codecrafters-io/frontend/public/assets/images/referral-program-features/get-one-year-free.png

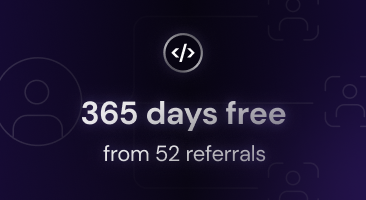
public/assets/images/referral-program-features/get-one-year-free.png
