codecrafters-io/frontend/public/assets/images/monthly-challenges/petoirobotdog.png

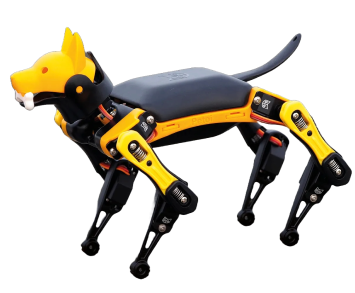
public/assets/images/monthly-challenges/petoirobotdog.png
