codecrafters-io/frontend/public/assets/images/affiliate-program-features/cc-profile-image.png

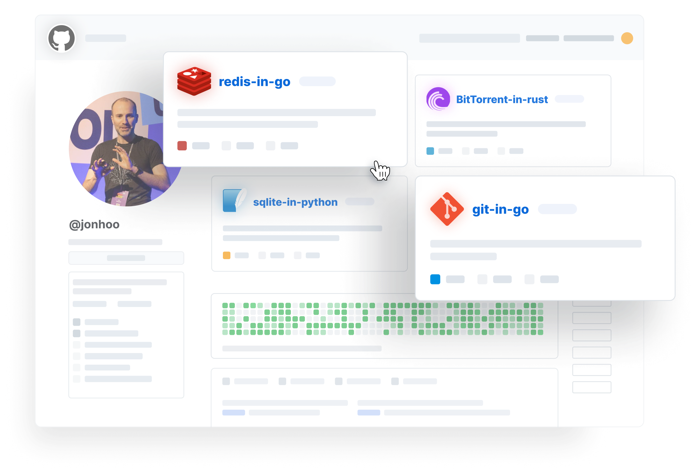
public/assets/images/affiliate-program-features/cc-profile-image.png
