codecrafters-io/frontend/public/assets/images/affiliate-program-features/free-for-friend.jpg

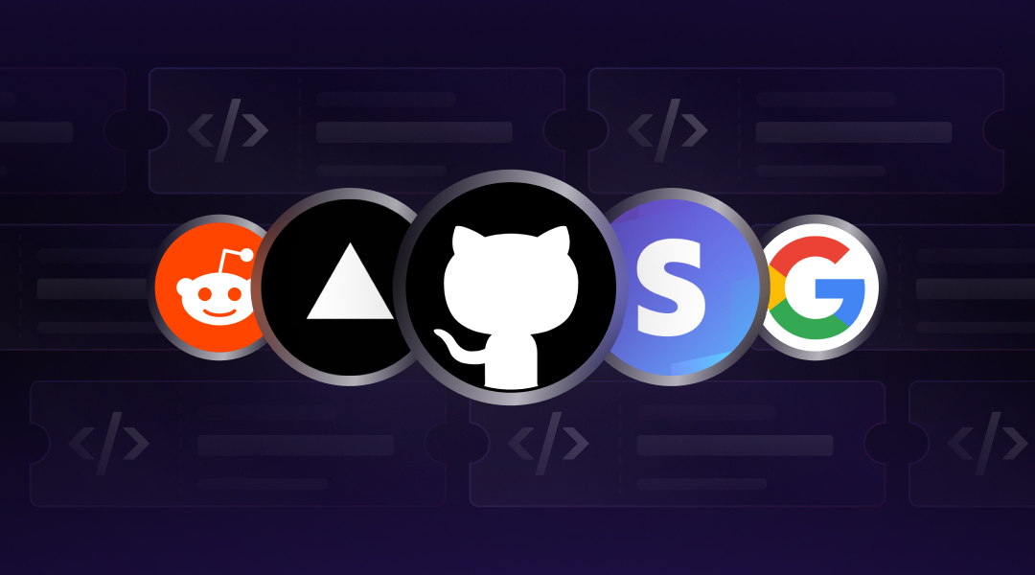
public/assets/images/affiliate-program-features/free-for-friend.jpg
