codecrafters-io/frontend/public/assets/images/affiliate-program-features/lifetime-earnings.jpg

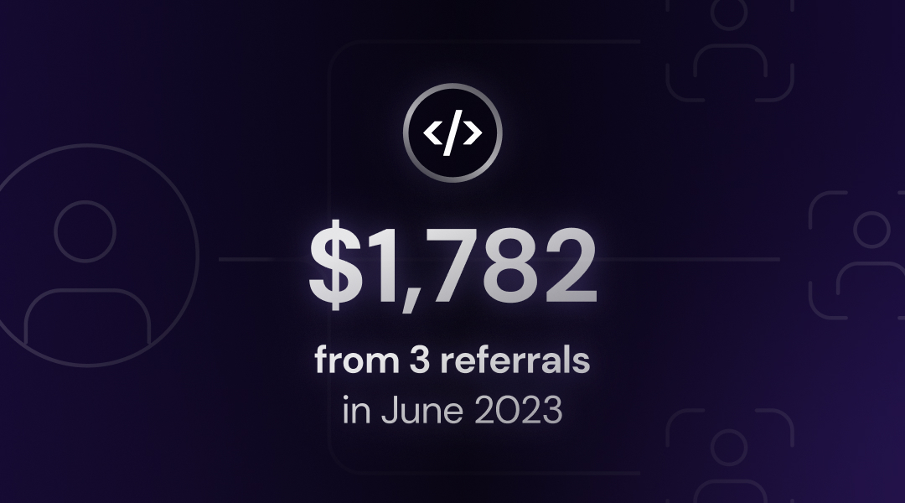
public/assets/images/affiliate-program-features/lifetime-earnings.jpg
