codecrafters-io/frontend/public/assets/images/affiliate-program-features/simple-payout.jpg

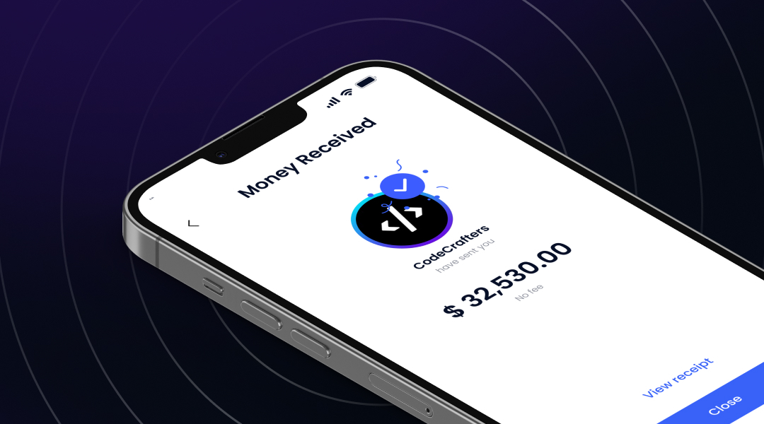
public/assets/images/affiliate-program-features/simple-payout.jpg
