codecrafters-io/frontend/public/assets/images/backer-headshots/arash-ferdowsi.png

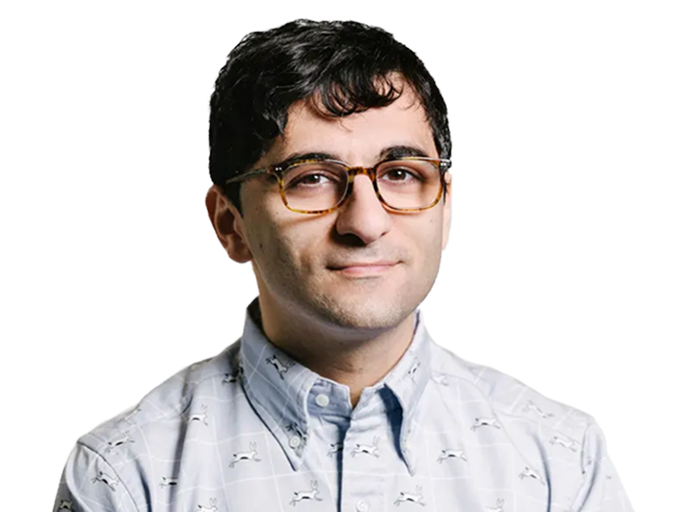
public/assets/images/backer-headshots/arash-ferdowsi.png
