codecrafters-io/frontend/public/assets/images/backer-headshots/jitendra-vaidya.png

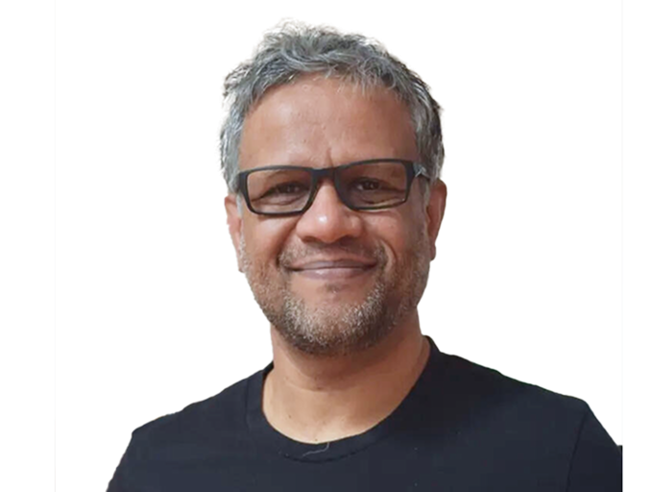
public/assets/images/backer-headshots/jitendra-vaidya.png
