codecrafters-io/frontend/public/assets/images/backer-headshots/jj-kasper.png

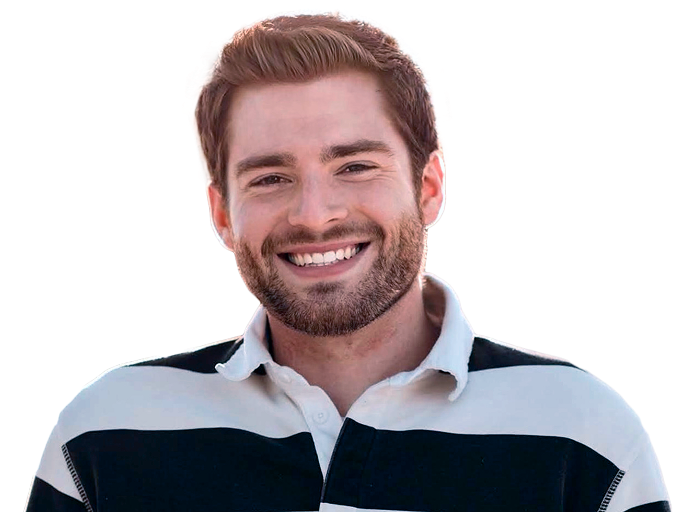
public/assets/images/backer-headshots/jj-kasper.png
