codecrafters-io/frontend/public/assets/images/backer-headshots/mike-krieger.png

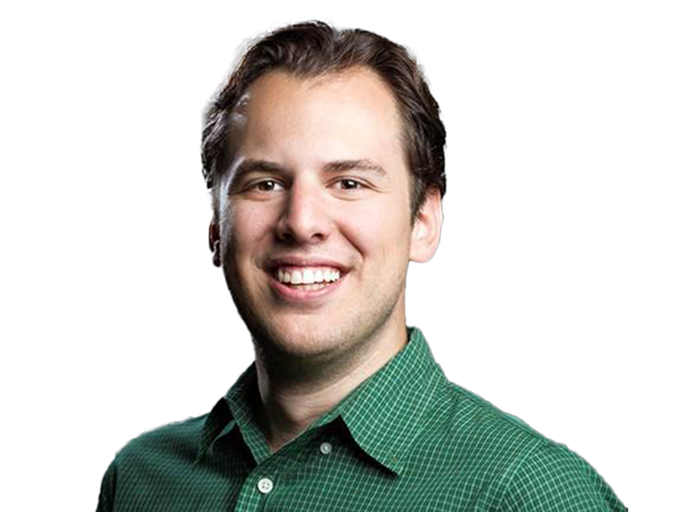
public/assets/images/backer-headshots/mike-krieger.png
