codecrafters-io/frontend/public/assets/images/backer-headshots/paul-copplestone.png

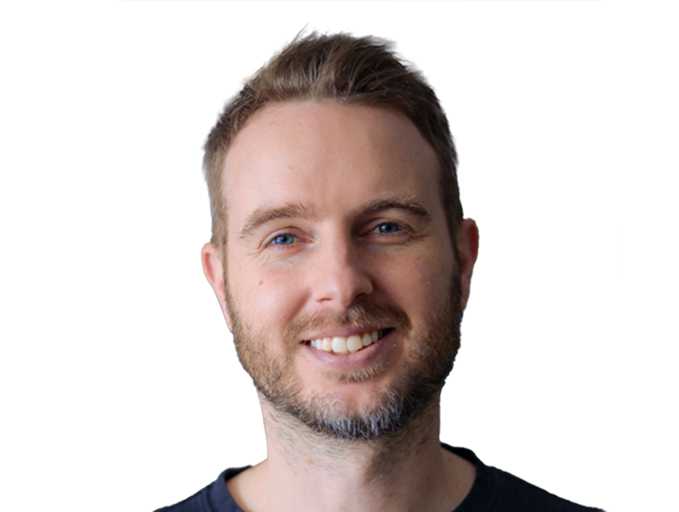
public/assets/images/backer-headshots/paul-copplestone.png
