codecrafters-io/frontend/public/assets/images/contest-og-images/og-amazon-contest-2.png

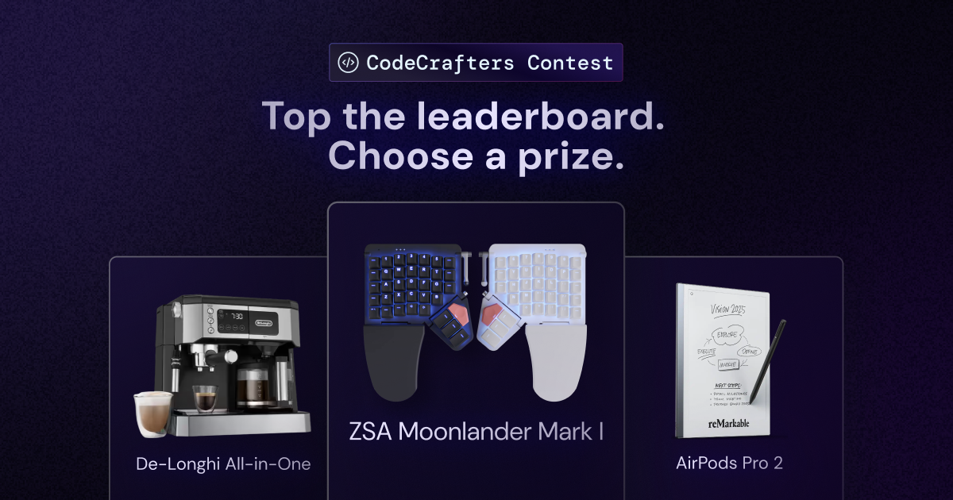
public/assets/images/contest-og-images/og-amazon-contest-2.png
