codecrafters-io/frontend/public/assets/images/contest-og-images/og-cais-contest-1.png

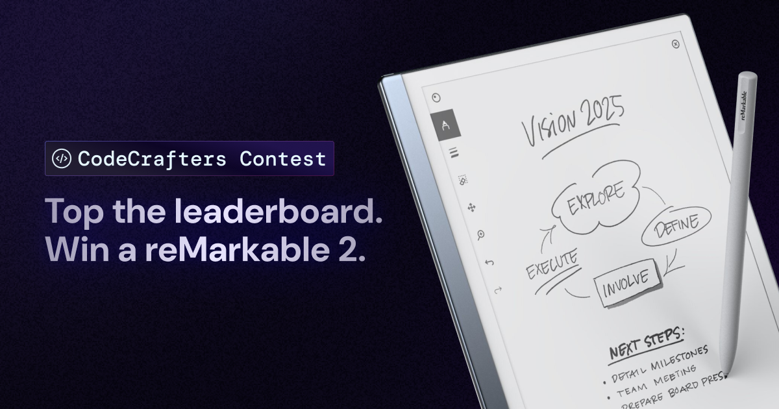
public/assets/images/contest-og-images/og-cais-contest-1.png
