codecrafters-io/frontend/public/assets/images/contest-prize-gif/amazon-contest-2-360.gif

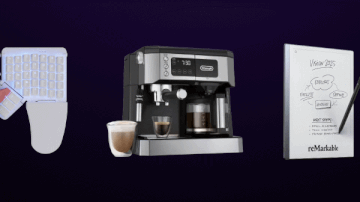
public/assets/images/contest-prize-gif/amazon-contest-2-360.gif
