codecrafters-io/frontend/public/assets/images/contest-prize-gif/cais-contest-1-600.png

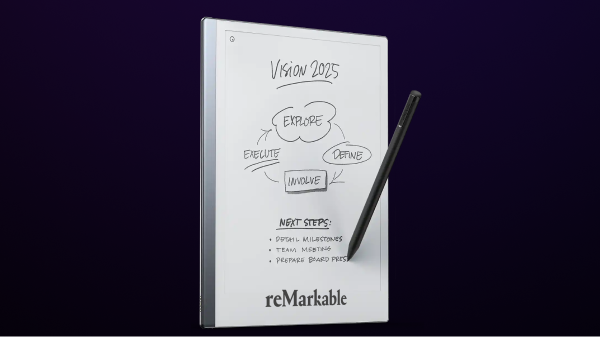
public/assets/images/contest-prize-gif/cais-contest-1-600.png
