codecrafters-io/frontend/public/assets/images/monthly-challenges/large.png

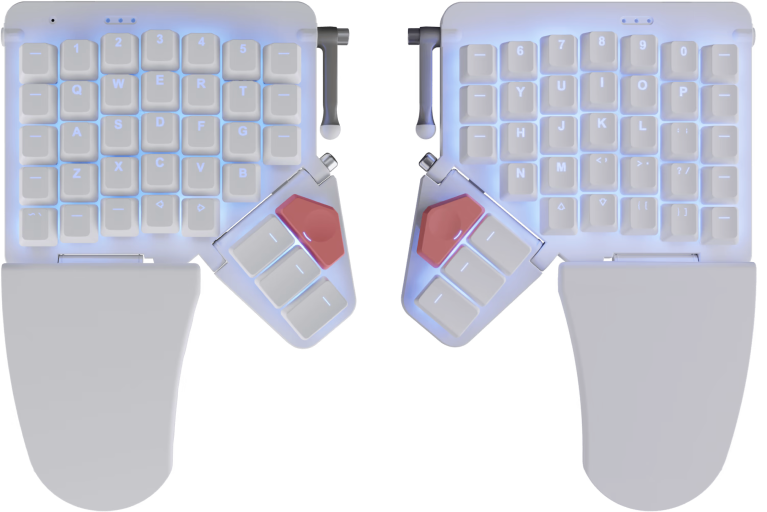
public/assets/images/monthly-challenges/large.png
