codecrafters-io/frontend/public/assets/images/monthly-challenges/opal-c1.png

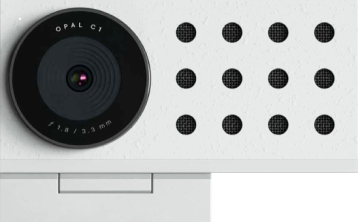
public/assets/images/monthly-challenges/opal-c1.png
