codecrafters-io/frontend/public/assets/images/monthly-challenges/oura-ring-horizon.png

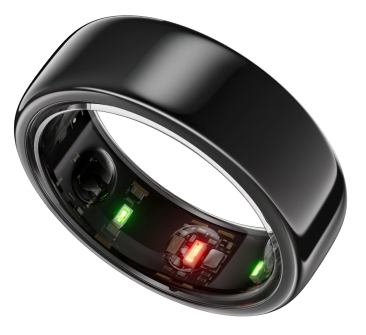
public/assets/images/monthly-challenges/oura-ring-horizon.png
