codecrafters-io/frontend/public/assets/images/monthly-challenges/small.png

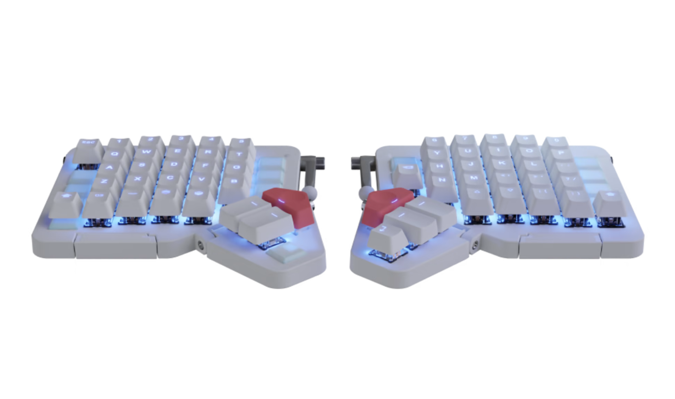
public/assets/images/monthly-challenges/small.png
