codecrafters-io/frontend/public/assets/images/referral-program-features/generate-link.png

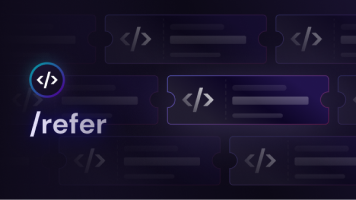
public/assets/images/referral-program-features/generate-link.png
