codecrafters-io/frontend/public/assets/images/Screenshot 2024-02-16 at 21.26.47.png

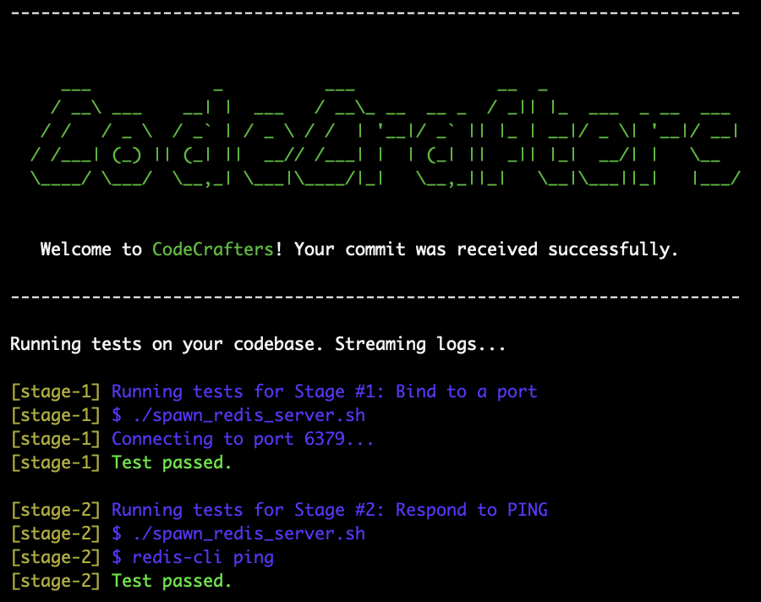
public/assets/images/Screenshot 2024-02-16 at 21.26.47.png
