codecrafters-io/frontend/public/assets/images/team-features/private-leaderboard.png

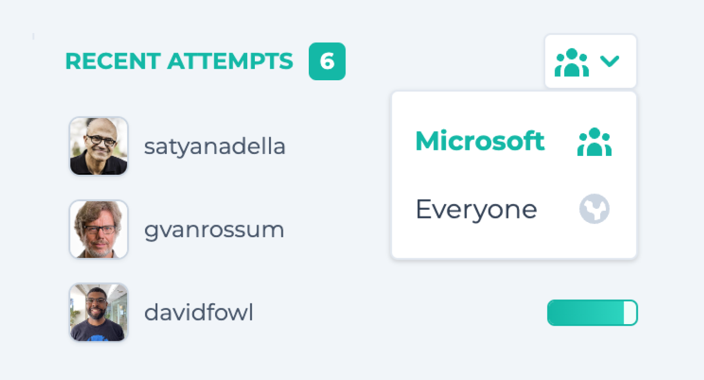
public/assets/images/team-features/private-leaderboard.png
