codecrafters-io/frontend/public/assets/images/team-features/slack-integration.png

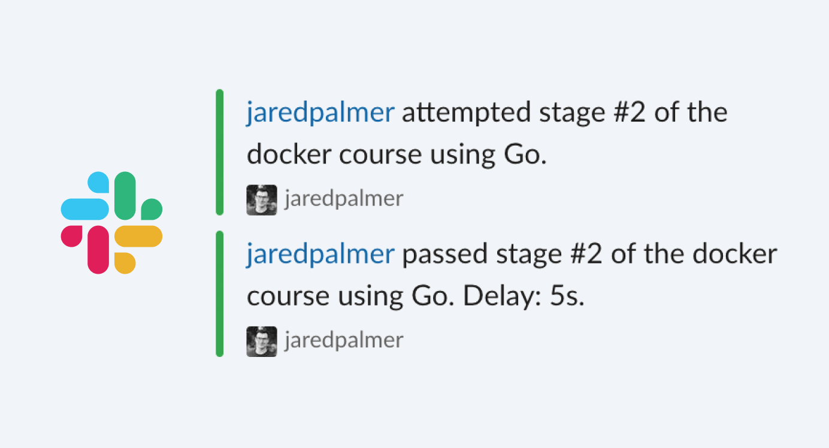
public/assets/images/team-features/slack-integration.png
