codecrafters-io/frontend/public/assets/images/team-features/team-billing.png

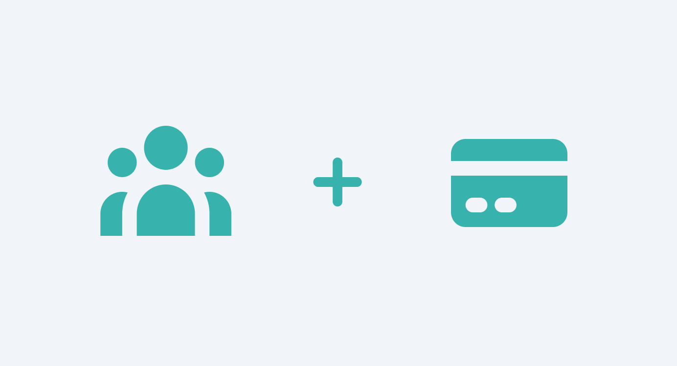
public/assets/images/team-features/team-billing.png
