codecrafters-io/frontend/public/assets/images/test.png

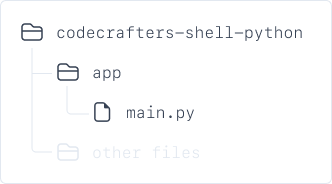
public/assets/images/test.png
