codecrafters-io/frontend/.rules/no-bugs.md

---
include: ['**/**.js', '**/**.ts', '**/**.hbs', '**/**.gts', '**/**.gjs']
---

Make sure our code follows these best practices, UNLESS there's a comment explaining why it's okay to break the rule.

1. Avoid typos.
2. Don't have like, really obvious bugs.
3. Follow reasonable conventions of the language we're programming in. No need to be too strict.
