codecrafters-io/frontend/(threads)

Thread 1415 (2024-03-05):

Dark Mode - foundations

rohitpaulk, 2024-03-05:
We've got a couple of pages / areas within pages that are currently in dark mode.

Examples:

- https://app.codecrafters.io/badges
- https://app.codecrafters.io/contests/weekly-7

We want to add dark mode throughout the app, but will do so incrementally since there'll be multiple components that need to be edited to make things look good.

As part of this task, let's add the "foundation" for this.

- We need dark mode state to be stored in local storage. The options are "light", "dark" and "system". The default will be "light".
- For staff, we need a way to toggle this in the UI. Let's add another link to account dropdown [here](https://github.com/codecrafters-io/frontend/blob/fd9d5570c1082fd6b1a0825d3b290c2e826b5487/app/components/header/account-dropdown.hbs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), below the Test Sentry link.
- When this is toggled, we need the "dark" class to be applied / removed from the application layout.
- Cleanup the `is-dark-mode` modifier - currently it's pretty hacky, uses intersectionobserver and what not
- Cleanup the `colorScheme` service, it currently uses hardcoded rules based on routes

Feel free to change the whole structure as much as you like, no need to stick to what we have already - most of this was added in a hurry and not properly thought out.

Note: We need all of this to work in such a way that customers aren't affected, but staff can toggle this at any time and inspect how things look. At the same time, once a staff switches things back to "light" mode, this should be treated the same as a regular user's browser. It's okay for `badges`, `contests` etc. to always be in dark mode, we aren't going to support light mode for those endpoints anytime soon.

Thread 1474 (2024-03-20):

"Update available" flow

rohitpaulk, 2024-03-20:
🚧 WIP

### Problem

We occasionally need to ship backend changes that are incompatible with new frontend versions.

### How we handle this currently

Until now our approach has been to keep changes backward compatible for a week or so, and then remove the backward compatibility code after.

### Requirements

We'd like to have a way to notify users that an update is available. We don't want to do this on _every_ update, only on ones that where we manually make a version bump.

rohitpaulk, 2024-07-29:
This was shipped!

Closed 2024-07-29.

Thread 1591 (2024-04-12):

Styling issue: Comments with code blocks extend past container

rohitpaulk, 2024-04-12:
From https://app.codecrafters.io/courses/http-server/stages/1:

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

(These comments might not be visible, so you'll need to create your own to actually replicate the issue)

rohitpaulk, 2025-01-31:
@VasylMarchuk can you confirm whether this has been fixed? I remember a seeing a PR that addressed something similar.

VasylMarchuk, 2025-03-30:
Nope, not yet fixed, tried looking at it today but didn't find an obvious fix

VasylMarchuk, 2025-04-05:
This has something to do with how avatars are displayed in the comments: if I hide them all, the sizing works flawlessly

Closed 2025-04-19.

Thread 2004 (2024-07-23):

Dark mode support tracking

rohitpaulk, 2024-07-23:
List of routes to add dark mode support for:

**Required for launch**:

- [x] catalog
- [x] account dropdown
- [x] course
- [x] course-overview
- [x] track
- [ ] vote
- [ ] concepts
- [ ] concept
- [ ] concept-group

**Not that important**:

- [ ] account-deleted
- [ ] code-walkthrough
- [ ] join
- [ ] login
- [ ] logged-in
- [ ] membership
- [ ] pay
- [ ] refer
- [ ] referral-link
- [ ] team
- [ ] teams.create
- [ ] update-required
- [ ] user
- [ ] not-found

rohitpaulk, 2025-01-31:
We've fixed most of there, the rest can be handled over time

Closed 2025-01-31.

Thread 2032 (2024-07-29):

Upgrade to ember 5.8

rohitpaulk, 2024-07-29:

VasylMarchuk, 2024-08-01:
Release notes:

- https://blog.emberjs.com/ember-released-5-8
- https://blog.emberjs.com/ember-released-5-7
- https://blog.emberjs.com/ember-released-5-6

VasylMarchuk, 2024-08-01:
Why not all the way to ember 5.10, which is currently latest? @rohitpaulk

rohitpaulk, 2024-08-01:
@VasylMarchuk LTS releases usually have fewer compatibility issues, 5.8 is the latest LTS if I'm not wrong. The only time we moved off LTS in the past was because there was an embroider compatibility issue and we had to upgrade to be able to use embroider.

VasylMarchuk, 2024-08-01:
Ah gotcha, 5.8 is latest LTS yep

Closed 2024-08-08.

Thread 2113 (2024-08-19):

Prevent spoiler alerts in Hints / CommentList

andy1li, 2024-08-19:
Re: [Help Scout #4875](https://secure.helpscout.net/conversation/2682855574/4875?viewId=4697252)

How can we prevent spoiler alerts?

Just listing ideas here, as a first step:

- Support collapse/uncollapse for the section. [Suggested by a user]
- Blur the section by default, like what we're doing with code examples for uncompleted stages.
- Some other way?

andy1li, 2024-08-20:
Moved to Linear.

Closed 2024-08-20.

Thread 2423 (2024-11-23):

Fix code block overflow in instructions card

rohitpaulk, 2024-11-23:
https://app.codecrafters.io/courses/bittorrent/stages/hw0

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

VasylMarchuk, 2024-11-24:
So if I change the way this magnet link is defined in the original instructions markdown from using single-ticks:

```
`magnet:?....`
```

to using triple-ticks, like this:

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

then it works @rohitpaulk:

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

VasylMarchuk, 2024-11-24:
I assume there's a way to edit the instructions markdown — but I'm not sure where?

rohitpaulk, 2024-11-25:
Ah, gotcha - @andy1li can you make that change please? @VasylMarchuk the markdown is stored [here](https://github.com/codecrafters-io/build-your-own-bittorrent/blob/main/course-definition.yml), but needs an admin to go and "apply" an update in the app.

@VasylMarchuk can you see if there's a CSS fix to prevent this happening even for inline code blocks? I can imagine cases where there's a not-so-long inline code block causing the same issue on smaller screens.

rohitpaulk, 2024-11-25:
Probably worth looking at what GitHub does: `thisisaverylongcodeblockthatisinlinethisisaverylongcodeblockthatisinlinethisisaverylongcodeblockthatisinlinethisisaverylongcodeblockthatisinlinethisisaverylongcodeblockthatisinlinethisisaverylongcodeblockthatisinlinethisisaverylongcodeblockthatisinlinethisisaverylongcodeblockthatisinline`

andy1li, 2024-11-25:
Testing too: ABC  `thisisaverylongcodeblockthatisinlinethisisaverylongcodeblockthatisinlinethisisaverylongcodeblockthatisinlinethisisaverylongcodeblockthatisinlinethisisaverylongcodeblockthatisinlinethisisaverylongcodeblockthatisinlinethisisaverylongcodeblockthatisinlinethisisaverylongcodeblockthatisinline` XYZ

VasylMarchuk, 2024-12-01:
> Probably worth looking at what GitHub does:

Ah, looks like they're simply using `word-wrap: break-word;` — cool, going to try this for our styles

Closed 2025-04-07.

Thread 2425 (2024-11-24):

Fix off-centered emoji in selected state

andy1li, 2024-11-24:
### Description
The emoji in the feedback modal appears off-centered when selected.

### Demo

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

https://demo.tryfix.ai/codecrafters/runs/c0b592b6-e4e5-41b7-bd2e-ee0438a74ba2?item=36

andy1li, 2025-01-05:
It seems to be fixed:

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

Closed 2025-01-05.

Thread 2515 (2025-01-05):

Markdowns are too wide in Bot comments to Code Examples

andy1li, 2025-01-05:
### Issue:

Users are forced to scroll horizontally to see the content of markdown.

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

### Reproduction Steps:

1. https://app.codecrafters.io/courses/http-server/stages/ia4/code-examples

2. language: go

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

3. user: bwfront

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

rohitpaulk, 2025-01-06:
This is a backend issue, the markdown content shouldn't contain a `pre` (the bot must be generating content with triple backticks inside)

rohitpaulk, 2025-01-13:
Just noting another user to test with: `jolly-pumpkin`.

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

rohitpaulk, 2025-01-13:
This is fixed for newer comments, running a job to fix older comments...

rohitpaulk, 2025-01-13:
Should be fixed now!

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

rohitpaulk, 2025-01-13:
@andy1li can we notify the user who let us know of this please?

Closed 2025-01-13.

Thread 2607 (2025-01-31):

Statically rendered user pages + concept pages

rohitpaulk, 2025-01-31:
We've been pre-rendering track pages and challenge pages by enumerating over all available tracks and challenges. We now need to find a way to statically generate user pages (there are 1000s of these), and concept pages (we'll have 100s of these in the near future).

Vercel's [Prerender functions](https://vercel.com/docs/build-output-api/v3/primitives#prerender-functions) API is supposed to allow for generating these on demand and caching. Let's implement this and also see if we can expose this as a generic ember plugin that others can use.

rohitpaulk, 2025-01-31:
@VasylMarchuk can you look into this please?

rohitpaulk, 2025-01-31:
@VasylMarchuk this is a bit time-sensitive, let's try to have it out by Feb 10

rohitpaulk, 2025-01-31:
For additional context - the reason we can't use the existing pre-rendering setup for these is that there are 1000s of these pages, and our deploys would take hours if we were to pre-render all of these pages.

VasylMarchuk, 2025-02-01:
Looking into this. Also, is my suspicion correct that since we're now going to render user-generated content (their user pages), we need to fix the DOMPurify `sanitize` issue? @rohitpaulk

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

rohitpaulk, 2025-02-04:
@VasylMarchuk yeah, we'll need to do something about that since user pages can contain UGC. It's okay if we do this in a hacky manner for now though - for example, if we just HTML-escaped all content when in fastboot mode (so it doesn't insert things like <script> tags), that might work. We can then re-visit getting DOMPurify to work properly in a different issue.

rohitpaulk, 2025-02-22:
This is done now! All's that pending is to make the 404 for concept pages work.

Closed 2025-03-29.

Thread 2782 (2025-04-06):

Errors that happen when executing Prerender Functions are not caught

VasylMarchuk, 2025-04-06:
### Brief

After closing #2607, it is possible for errors to sneak in that happen only when our Prerender Functions are executed, and nothing currently is checking for them or triggering any alerts/notifications.

### Details

As a simple solution, we have to pre-render one User and one Concept page **at deployment time using Prember**, to catch any potential errors during deployment.

Closed 2025-04-07.

Thread 2860 (2025-05-28):

Sync hover state for collapsed lines gutter and editor

rohitpaulk, 2025-05-28:
Let's have this feel like a single element by syncing hover state:

https://github.com/user-attachments/assets/18305773-b0d3-4c72-b410-40e3e840213b

This should be done for both the diff view and the file view. If it makes it easier, we can discard the codemirror unchanged lines collapse implementation and just replace that whole usage with ours since we now have a custom collapsed lines implementation.

Closed 2025-06-11.

Thread 3100 (2025-09-16):

SIdebar expansion icon should not be hidden by content mask

rohitpaulk, 2025-09-16:
In the course page, when content is hidden by a modal the sidebar expansion icon is half-hidden:

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

This should instead appear above the content mask
