codecrafters-io/frontend/(commit log)

2024-05-06 fix: Add an isDisabled clause to the move down button
2024-05-06 feat: Added assertions in test for disabled buttons on first and last options
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2024-05-12 feat: Handle case where an option index that is out of bounds is passed to handler
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2024-05-13 Refactor non-active repository link template
    The non-active repository link template in the course page repository dropdown has been refactored. Changes include:
    • Added proper indentation and line breaks for better readability.
    • Reorganized the image tags for the repository language logos.
    • Added a missing newline at the end of the file.
    These changes improve the structure and maintainability of the template.
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2024-05-14 Add onExpand event handler to CommunitySolutionCardComponent and CommunitySolutionsListComponent. When the onExpand event is triggered, it checks if the user is authenticated and then calls the creat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
2024-05-14 Refactor community solution card components and add metadata for upvote and downvote buttons.
2024-05-16 Refactor code example evaluator page components and routes
    The commit message summarizes the changes made to the code. In this case, the changes involve refactoring the code example evaluator page
    components and routes.
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2024-05-20 Refactor code to remove unnecessary arguments in ActionButtonListComponent and fix pin-code-example test
2024-05-20 Fix stage URLs in acceptance tests and update progress text in leaderboard test.
2024-05-20 Update course and track progress display
    The commit message summarizes the changes made in the code. In this case, the changes involve updating the progress display for courses and
    tracks in the acceptance tests. The progress text and progress bar style have been modified to reflect the correct number of stages.
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2024-05-22 Update branch name from 'master' to 'main' in GitHub workflows and README.md
    This commit updates the branch name from 'master' to 'main' in the following files:
    • .github/workflows/test.yml
    • README.md
    • sweep.yaml
    The changes include updating the branch name in the on section of the workflow file, the condition for enabling Percy in the
    workflow file, and the deployment description in the README.md file.
    This commit also updates the branch name in the sweep.yaml file, specifically in the branch field.
    These changes ensure consistency with the updated branch naming convention.
2024-05-22 fix stage comments test
2024-05-23 refactor: Avoid conditionally setting up timer in initializer
2024-05-23 Fix race condition causing blank explanation in FeedbackPromptComponent and save the explanation in submit-course-stage-feedback-test.js.
2024-05-26 Update import path for syncRepositoryStageLists in repositories.js
    This commit updates the import path for syncRepositoryStageLists in repositories.js from './utils/sync-repository-stage-lists'
    to '../utils/sync-repository-stage-lists'. This change ensures that the correct module is imported and used in the code.
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2024-05-27 feat: Add test for submitting course stage feedback after passing base stage
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2024-05-29 refactor: Add method that advances time in time service instead of relying on fake-timers
2024-05-29 fix: Handle case where isFastboot is true
2024-05-29 Add copy to clipboard functionality and handle button click in evaluation-tab component.
2024-05-29 Update evaluation sorting and display in code example evaluator page and evaluation card components.
    • Sort evaluations by updatedAt instead of createdAt in EvaluationsSection component.
    • Display "Regenerating..." text when evaluation requires regeneration in evaluation-tab.hbs template.
    • Display updatedAt instead of createdAt in header.hbs template.
    • Add updatedAt attribute to CommunitySolutionEvaluationModel model.
    These changes improve the accuracy of evaluation sorting and provide updated information in the UI.
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2024-06-05 feat: Added another test to check if modal status is affected by updates to course stage
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2024-06-10 feat: Filtered out deprecated course stages from being included in stages count in language cards on tracks page
2024-06-10 feat: Filtered out course progress list items for deprecated courses on the user profile page
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2024-06-21 feat: Added tooltip for refresh from github button when anonymous mode is enabled
2024-06-21 fix: Ensure tooltip is not affected by stylistic changes of button being disabled
2024-07-02 build(deps-dev): Bump @types/rails__actioncable from 6.1.10 to 6.1.11
    Bumps [@types/rails__actioncable](https://github.com/DefinitelyTyped/DefinitelyTyped/tree/HEAD/types/rails__actioncable) from 6.1.10 to 6.1.11.
    - [Release notes](https://github.com/DefinitelyTyped/DefinitelyTyped/releases)
    - [Commits](https://github.com/DefinitelyTyped/DefinitelyTyped/commits/HEAD/types/rails__actioncable)
    ---
    updated-dependencies:
    - dependency-name: "@types/rails__actioncable"
    dependency-type: direct:development
    update-type: version-update:semver-patch
    ...
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2024-07-16 Use a map instead of using a switch (to make CodeRabbit happier)
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2024-07-27 Refactor continue-or-step-back.ts: Update button text and visibility
    The commit message summarizes the changes made to the file "continue-or-step-back.ts". In this commit, the button text and visibility properties were
    modified. The continue button text was updated, and the step back button visibility property was removed. The changes were made to improve the user
    experience and enhance the functionality of the component.
2024-07-28 Remove unused button-with-spinner.js file and add button-with-spinner.ts file with glimmer component implementation.
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2024-08-11 Add course stage slugs to participation query and display system submission in timeline entry container.
2024-08-12 build(deps): Bump @rails/actioncable from 7.1.3 to 7.2.0
    Bumps [@rails/actioncable](https://github.com/rails/rails) from 7.1.3 to 7.2.0.
    - [Release notes](https://github.com/rails/rails/releases)
    - [Commits](https://github.com/rails/rails/compare/v7.1.3...v7.2.0)
    - dependency-name: "@rails/actioncable"
    dependency-type: direct:production
    update-type: version-update:semver-minor
    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
2024-08-19 chore(deps-dev): bump ember-svg-jar from 2.4.9 to 2.5.0
    Bumps [ember-svg-jar](https://github.com/voltidev/ember-svg-jar) from 2.4.9 to 2.5.0.
    - [Release notes](https://github.com/voltidev/ember-svg-jar/releases)
    - [Changelog](https://github.com/evoactivity/ember-svg-jar/blob/master/CHANGELOG.md)
    - [Commits](https://github.com/voltidev/ember-svg-jar/commits)
    - dependency-name: ember-svg-jar
    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
2024-08-21 Fix auto-selecting of Preferred Language by queryParams['track']
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2024-08-23 Refactor components to improve TypeScript compatibility and update dependencies.
    [course-idea-card.gts, submit-course-idea-card.gts, unvote-button.gts, vote-button.gts]
2024-08-23 update invert styling
    [vote-button.gts]
2024-08-23 chore(deps): bump @rails/actioncable from 7.2.0 to 7.2.100
    Bumps [@rails/actioncable](https://github.com/rails/rails) from 7.2.0 to 7.2.100.
    - [Commits](https://github.com/rails/rails/commits)
    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
2024-10-02 chore(deps-dev): bump ember-svg-jar from 2.5.0 to 2.6.0
    Bumps [ember-svg-jar](https://github.com/voltidev/ember-svg-jar) from 2.5.0 to 2.6.0.
    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
2024-10-07 Add support for zero decimal currencies in Charge model and normalize amounts.
2024-10-07 Update currency formatting for CNY to include 'CN' prefix in charge model.
2024-10-07 Fix currency formatting for CNY in Charge model.
2024-10-07 fix: update currency symbol from C$ to CA$ for Canadian dollars in charge model
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2024-10-16 chore(deps): bump @rails/actioncable from 7.2.100 to 7.2.101
    Bumps [@rails/actioncable](https://github.com/rails/rails) from 7.2.100 to 7.2.101.
    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
2024-10-17 Update modal text to refer to "current step" instead of specific step title.
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2024-10-18 Update modal text to conditionally display "stage" or "step" based on type.
2024-10-24 chore(deps): bump @rails/actioncable from 7.2.101 to 7.2.102
    Bumps [@rails/actioncable](https://github.com/rails/rails) from 7.2.101 to 7.2.102.
    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
2024-10-31 chore(deps): bump @rails/actioncable from 7.2.102 to 7.2.200
    Bumps [@rails/actioncable](https://github.com/rails/rails) from 7.2.102 to 7.2.200.
    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
2024-11-05 Prevent submit when button is disabled
2024-11-13 Add loading state for delete button and prevent multiple deletions in modal.
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2024-11-16 Refactor feature flag checks for stage 2 solutions to improve logic clarity.
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2024-11-22 Rename second stage instructions card to second stage tutorial card across files.
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2024-11-22 Fix ID in second-stage tutorial card and remove unnecessary pause in tests.
2024-11-22 Update test cases to suggest Git commands for stage 2 and CLI for stage 3.
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2024-11-26 Refactor resume track button logic and add acceptance tests for track-page [percy]
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2024-11-29 Add hide solution button functionality and test coverage for second stage tutorial card.
2024-11-29 fix: Update button class in implement-solution-step.hbs [percy]
2024-12-03 chore(deps): bump @rails/actioncable from 7.2.200 to 8.0.0
    Bumps [@rails/actioncable](https://github.com/rails/rails) from 7.2.200 to 8.0.0.
    - [Commits](https://github.com/rails/rails/commits/v8.0.0)
    update-type: version-update:semver-major
    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
2024-12-11 chore(deps): bump @rails/actioncable from 8.0.0 to 8.0.1
    Bumps [@rails/actioncable](https://github.com/rails/rails) from 8.0.0 to 8.0.1.
    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
2024-12-13 feat: Add feature flag to show tweaks for stage 1 tutorial card in first-stage-tutorial-card component [percy]
2024-12-17 fix: Correct optional chaining in two components
2024-12-18 chore: Fix typo in error message in course-stage model
2024-12-19 fix: Update member listing to display GitHub name and modify test to click leave button by GitHub name instead of username. Fix memberByGithubName method to find member by GitHub name.
2024-12-21 refactor: Modify code to show short instructions for stage 2 based on feature flag status
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2024-12-23 fix: Update variable name in FirstStageTutorialCardComponent to currentCourse (#123)
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2024-12-26 Revert "Experiment: Stage 1 - Hide Test Runner Card Before User Has Submitted Again"
2024-12-27 feat: Add option to show all steps at once in first-stage tutorial card [percy]
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2024-12-27 chore: Remove unnecessary code duplication and improve forum link in first stage tutorial card and instructions page
2024-12-27 feat(stage): rename `shouldShowNeedHelpForumLink` to `shouldShowStage1ForumLinkCTA` and update its logic
    Updated the name of the `shouldShowNeedHelpForumLink` property to `shouldShowStage1ForumLinkCTA` and modified its logic to align with its new name.
2024-12-31 fix: Add repo query param to start-track-button component
    Updated the start-track-button component to include a 'repo' query param when transitioning to the course route if the user is not anonymous. This change allows for better handling of repository information in the transition.
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2025-01-06 refactor: Remove the feature flag for showing all steps at once for first stage tutorial card
2025-01-06 feat: Remove feature flag for showing short instructions in second stage tutorial card
2025-01-07 feat: Add conditional rendering for terminal instructions in first and second stage tutorial cards and feature flag logic [percy]
2025-01-07 refactor: Update tutorial cards layout and tooltips on course page stage steps
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2025-01-07 fix: Update conditional logic for showing terminal instructions in first-stage-tutorial-card component
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2025-01-12 fix: Update second stage tutorial message in course-stage-step component
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2025-01-18 feat: update discount models and refactor related logic
    Refactor the discount handling in the application by introducing a new
    PromotionalDiscount model. Update the included resources to use
    consistent naming conventions. Modify the logic in various components
    to utilize the new model and properties, ensuring that discount
    calculations reflect the current user's active discounts. This
    improves code clarity and enhances the user experience by providing
    accurate discount information.
2025-01-22 refactor: move UpgradePrompt component to new location
    Moves the UpgradePrompt component from the course-stage-step
    directory to the course-page directory. This change improves
    the organization of components by grouping related files
    together, enhancing maintainability and clarity in the codebase.
2025-01-22 refactor: comment out user sync during discount fetch
    Comments out the call to sync the current user in the
    handleDidInsert method. This change improves performance
    by preventing unnecessary user synchronization while
    fetching regional discounts.
2025-01-22 feat(auth): refactor user synchronization and login flow
    Removes deprecated login and logout methods from the
    AuthenticatorService. Introduces a new UserSyncer service
    to handle user synchronization on route changes, ensuring
    that user data is up-to-date. Updates the authenticate
    method to call syncCurrentUser, improving the login flow
    and user experience. Adjusts the AcceptReferralButton
    component to use syncCurrentUser for refreshing user
    data, enhancing consistency across the application.
2025-01-22 refactor: remove forceSync method and streamline sync logic
    Eliminate the redundant forceSync method to simplify the codebase.
    Update the handleRouteChange method to directly call syncCurrentUser,
    ensuring a more efficient synchronization process for the current user.
    This change enhances maintainability and improves clarity in the
    synchronization workflow.
2025-01-22 refactor: instance initializers to TypeScript
    Convert JavaScript instance initializers to TypeScript for better
    type safety and maintainability. Remove outdated JavaScript files
    and implement TypeScript versions for `sentry`, `current-user`,
    `page-view-tracker`, `web-vitals`, `posthog`, and `feature-flag-syncer`.
    This change enhances code quality and prepares the codebase for
    future development.
2025-01-22 fix: update isPaid condition for course stages
    Adjust the isPaid condition to include courses at position 3. This
    change ensures that the correct payment status is applied to
    courses that are at the third position or higher.
2025-01-22 fix: enable user synchronization on upgrade prompt
    Enables user synchronization in the upgrade prompt component
    by uncommenting the syncCurrentUser method. This ensures that
    the current user's data is properly synchronized when the
    component is inserted, improving the accuracy of user-related
    information displayed on the course page.
2025-01-22 feat: add second stage completion trait and tests
    Implement the `withSecondStageCompleted` trait to create
    submissions for the first two stages of a course with
    failure and completion statuses. Add acceptance tests to
    verify the upgrade prompt displays the correct copy based
    on user eligibility for discounts. This enhances the
    course progression simulation and ensures accurate
    user messaging.
2025-01-23 feat: enhance signup discount notice component [percy]
    Updates the signup discount notice with a new design and
    functionality. Changes include a gradient background, an
    animated icon, and a countdown timer for the offer's
    expiration. Adds a tooltip for additional information on
    the annual plan discount. This improves user engagement
    and clarity on the offer details.
2025-01-23 refactor: extract time formatting logic into a utility function
    This commit introduces a new utility function `formatTimeLeft` in `time-formatting.ts` to handle the countdown timer logic for discount expiration. The `timeLeftText` getters in both `ReferralDiscountNoticeComponent` and `SignupDiscountNoticeComponent` have been updated to utilize this new function, simplifying the code and improving maintainability.
2025-01-23 refactor: consolidate referral discount notice logic into a single component
    This commit removes the `referral-discount-notice-with-countdown.hbs` file and integrates its functionality into `referral-discount-notice.hbs`. The component now conditionally renders different layouts based on the `@variant` property, simplifying the code structure and improving maintainability. The countdown timer and referral offer details are preserved, enhancing the user experience.
2025-01-23 refactor: integrate countdown notice into signup discount component
    This commit removes the `signup-discount-notice-with-countdown.hbs` file and incorporates its functionality into `signup-discount-notice.hbs`. The component now conditionally renders different layouts based on the `@variant` property, maintaining the countdown timer and offer details while simplifying the code structure. This change enhances maintainability and improves the user experience.
2025-01-24 feat(billing): add discount timer badge component
    Implement the DiscountTimerBadge component to display a countdown for
    promotional discounts. Integrate the component into the header and
    navigation controls, replacing existing VIP and member badge logic.
    Add acceptance tests to verify the discount countdown functionality.
    This enhances user experience by providing timely information on
    discounts available.
2025-01-24 feat(header): integrate active discount display in header component
    - Added logic to conditionally render the DiscountTimerBadge based on the active discount for the yearly plan.
    - Introduced a computed property to retrieve the active discount from the current user, enhancing the user interface with real-time discount information.
2025-01-24 feat: enhance navigation controls to display active discount for yearly plan
    - Updated the navigation controls to conditionally render the DiscountTimerBadge with the active discount information for the yearly plan.
    - Introduced a computed property to retrieve the active discount from the current user, improving the user interface with real-time discount visibility.
2025-01-27 feat: add BillingStatusBadge component for dynamic billing status rendering
    Create a new component to handle various billing status scenarios, including VIP badge, member badge, discount timer, free weeks, and upgrade button
2025-01-27 feat: add `size` prop to `BillingStatusBadge` component
    Add a size prop to the BillingStatusBadge component to support different display sizes in header and course page navigation controls
2025-01-27 feat: add size prop to VIP badge component
    Enhance VipBadge component with configurable size options, supporting 'small' and 'large' display sizes with responsive styling
2025-01-27 feat: add size prop to Member badge component
    Enhance MemberBadge component with configurable size options, supporting 'small' and 'large' display sizes with responsive styling
2025-01-27 feat: propagate size prop to DiscountTimerBadge component
    Update DiscountTimerBadge to accept and apply the size prop consistently, adding margin for small size and maintaining responsive styling
2025-01-27 feat: add size prop to FreeWeeksLeftButton component
    Enhance FreeWeeksLeftButton with configurable size options, supporting 'small' and 'large' display sizes with responsive margin and button sizing
2025-01-27 refactor: update FreeWeeksLeftButton component size prop handling
    Modify the component to map size prop values more precisely, adjusting the linkButtonSize getter and template to ensure consistent sizing and margin behavior
2025-01-27 feat: enhance BillingStatusBadge upgrade button sizing and margin
    Modify the BillingStatusBadge component to dynamically adjust the upgrade button size and margin based on the size prop, ensuring consistent styling across different contexts
2025-01-27 refactor: update MemberBadge component size prop mapping
    Modify the MemberBadge component to map size prop values more precisely, adjusting the linkButtonSize getter and template to ensure consistent sizing and margin behavior
2025-01-29 fix: correct conditional rendering for discount timer badge
    Adjust the condition for displaying the discount timer badge to ensure it only shows when both an active yearly plan discount exists and the discount countdown can be seen
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2025-01-29 fix: add glint type assertion for discount timer badge
2025-01-29 feat: add stage 2 completion promotional discount type
    Extend promotional discount model and user model to support a new 'stage_2_completion' discount type, enabling additional discount scenarios
2025-01-29 feat: add Stage 2 completion discount notice component
    Create a new component to display a promotional discount notice for users who complete stage 2, featuring a time-limited 40% off annual plan offer with animated icon and tooltip
2025-01-29 feat: render Stage 2 completion discount notice on pay page
    Add conditional rendering for the new Stage 2 completion discount notice component when applicable, integrating the promotional discount display into the pay page template
2025-01-29 feat: add promotional discounts to repository poller and extend pay page tests
    Add 'user.promotional-discounts' to repository poller tracked events and expand pay page test coverage with new scenarios for Stage 2 completion discount and course stage completion
2025-01-29 test: add test for Stage 2 completion discount flow
    Extend pay page tests to verify the Stage 2 completion discount mechanism, including creating a test scenario that simulates completing stage 2 and checks the associated promotional discount
2025-01-29 test: enhance Stage 2 completion discount test coverage
    Update pay-test.js to improve test scenarios for Stage 2 completion discount, including:
    - Adding explicit assertions for discount timer badge visibility and time remaining
    - Verifying badge click navigates to pay page
    - Refining test case descriptions and implementation details
2025-01-29 test: add discount timer badge page object methods
    Enhance page object files for header components by:
    - Adding isVisible method for discount timer badge
    - Including text and timeLeftText methods
    - Standardizing discount timer badge page object structure across components
2025-01-29 test: adjust Stage 2 completion discount timer test assertions
    Update pay-test.js to fine-tune discount timer badge test assertions:
    - Modify expiration time calculation to reflect 23 hours remaining
    - Ensure accurate time remaining text matches expected behavior
2025-01-29 test: update view-discount-countdown test assertions
    Refactor discount timer badge test assertions to use page object methods:
    - Replace direct DOM assertions with page object methods
    - Improve test readability and maintainability
    - Standardize assertion approach across different test scenarios
2025-01-29 test: add size-related methods to discount timer badge page objects
    Add hasSmallSize and hasLargeSize methods to header component page objects for discount timer badge, enabling size-related assertions in tests
2025-01-29 test: extract billing status badge page object to shared component
    Refactor page objects for header and course page header by:
    - Creating a new shared billing-status-badge.js page object
    - Moving common badge and button selectors to the shared component
    - Simplifying import and usage across different page objects
2025-01-29 test: adjust Stage 2 completion discount timer test expiration time
    Update pay-test.js to modify the Stage 2 completion discount timer test:
    - Change expiration time calculation from 24 hours minus 10 seconds to 24 hours minus 30 minutes
    - Ensure more realistic test scenario for discount timer badge
2025-01-29 fix track preview [percy]
2025-01-30 feat: sync user after stage completion and remove promotional discounts fetching from repo poller
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2025-01-30 feat: enhance discount badge display logic for Stage 2 completion when using feature flags
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2025-02-01 feat: add support for additional attributes in leaderboard
    Update the track leaderboard component to accept additional
    attributes. This change enhances the component's flexibility
    by allowing it to be more easily integrated with other
    elements and styles in the application.
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2025-02-04 feat: add getter for active yearly plan discounts excluding stage 2 completion
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2025-02-04 refactor: update header spacing and layout adjustments
    Reduce the bottom margin of the track title for better spacing.
    Adjust the layout of the track page by modifying padding and
    margins for a more consistent design. Simplify the track
    description markdown method to improve readability and
    maintainability.
2025-02-04 feat(header): add statistics component to track page header
    Introduce a new `TrackPage::Header::Statistic` component to display
    statistics in the track page header. This component accepts `description`
    and `icon` as arguments, enhancing the visual representation of key
    metrics. Update the header template to include two instances of this
    component, showcasing the number of learners and exercises. Adjust
    styling for better layout and readability.
2025-02-04 feat: update track header to use dynamic language name
    Refactor the track page header to display the language name
    dynamically. Remove the `trackTitle` getter from the language
    model and directly integrate the name into the header. This
    improves localization and ensures the title reflects the
    current language context.
2025-02-04 feat(header): improve layout and responsiveness of header
    Adjusts the header layout by modifying the flex properties and
    margins for better spacing. Adds a responsive LanguageLogo
    component that displays on smaller screens, enhancing the
    user experience across devices.
2025-02-04 feat(header): update statistic description to use dynamic count
    Update the TrackPage header to display the number of exercises
    dynamically based on the current language's stages count. This
    change enhances the user experience by providing accurate and
    localized information.
2025-02-04 refactor: restructure track.hbs layout for clarity
    Wraps the main content in a white background for better
    visual separation. Adjusts indentation for improved
    readability and maintains the existing structure of
    components. This change enhances the overall layout
    and prepares for future modifications.
2025-02-04 implement dark mode [percy]
    Enables dark mode for the track page by updating styles and
    components. Changes include modifying button styles, adding
    dark mode snapshots in tests, and adjusting text colors for
    better visibility. This improves user experience for users
    who prefer dark mode.
2025-02-04 fix(header): increase max width of track description
    Update the max width of the track description paragraph to
    max-w-2xl for better readability. This change enhances the
    visual presentation of the track description on the page.
2025-02-04 feat: update page title for concept editing view
    Change the page title in the concepts admin template to reflect the
    specific concept being edited. The title now concatenates "Edit Concept: "
    with the concept's title or defaults to "Unknown" if no title is present.
    This improves clarity for users by providing context on the current
    action being performed.
2025-02-05 revert: changes made to track checkout button clicks
2025-02-11 feat(header): update layout for better
    Adjusts the layout by adding "flex-grow" class to the
    container div. This change improves the spacing and alignment
    of the header elements, enhancing the overall visual
    presentation of the track page.
2025-02-11 feat: add join-track route and model handling
    Implements the join-track route to manage track joining
    functionality. This includes defining the model structure,
    loading necessary data, and handling transitions based on
    affiliate links and language. The route allows anonymous
    access and updates metadata for SEO purposes.
2025-02-11 feat: enhance track page with join functionality
    Adds a new join track page that reuses components from the track
    page. Implements conditional rendering for call-to-action
    in the header based on user state. Updates page titles to reflect
    the user's affiliate link. Introduces tests for the new join track
    page to ensure functionality.
2025-02-11 feat: add language support to affiliate link components
    Adds language handling to the affiliate link page components.
    Introduces a new `language` argument in the `AcceptReferralContainer`
    and `AcceptReferralButton` components. Updates the routing logic
    to transition to the appropriate track based on the provided
    language. Enhances the join track template to include the
    `AcceptReferralContainer` for both mobile and desktop views,
    improving user experience and accessibility.
2025-02-11 feat: add affiliate link slug handling in join track page
    Add support for affiliate link slugs in the join track page. Update tests
    to create affiliate links with a slug and verify behavior when visiting
    the page with valid and invalid slugs. This enhances the routing logic
    and improves user experience by providing clearer navigation paths.
2025-02-11 refactor: update language handling in templates
    Replace course reference with language in AffiliateLink
    components. Adjust layout properties for consistency and
    improve responsiveness in join-track and track templates.
    This enhances the user experience by ensuring the correct
    language context is passed and improves the visual
    alignment of elements.
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2025-02-13 feat: update concept completed modal for clarity and style
    Refactor the concept completed modal to enhance user experience.
    Adjust the text to clarify the data requested from GitHub and
    improve the layout by adding a gradient background and
    increasing the button icon size. These changes aim to provide
    a more visually appealing and informative interface for users
    completing the concept.
2025-02-13 feat: add login handling to concept completed modal
    Implement login functionality for the concept completed modal by adding a click handler that initiates GitHub authentication. The handler dynamically determines the redirect path based on the current concept group, ensuring users are returned to the appropriate section after signing in.
2025-02-13 feat: enhance concept completed modal with backend-driven signup flow
    Modify the login handling in the concept completed modal to use a backend redirect flow. This ensures concept completion state is preserved during authentication and handles edge cases like browser refresh. The changes include:
    - Constructing a backend URL to mark concept as complete
    - Adding a redirect URL parameter to the authentication flow
    - Improving comment explaining the new signup process
2025-02-13 feat: improve login redirection handling in authenticator service
    Add support for handling full backend URLs during login redirection, ensuring proper authentication flow for various redirect scenarios
2025-02-13 refactor: optimize completedBlockGroupsCount logic
    Refactor the completedBlockGroupsCount getter to improve clarity and
    performance. Replace the completedBlockGroups variable with
    blocksInPreviousGroupsCount and result to track the count of blocks
    and the number of completed block groups more effectively. This change
    enhances readability and maintains the same functionality.
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2025-02-20 fix: update concept group fetching to use findAll with filter
2025-02-20 feat: improve anonymous user concept completion flow
    Add support for marking concepts as complete for anonymous users by:
    - Implementing a sign-in button in the concept completed modal
    - Constructing a backend URL with the correct redirect path
    - Using animationsSettled to ensure smooth modal interactions
    - Displaying a dynamic access message based on the concept group
2025-02-20 feat: add page object support for concept completed modal
    Extend the concept page test helper with a new page object for the concept completed modal, including:
    - Scoping the modal element
    - Adding methods to check modal visibility
    - Providing text retrieval
    - Implementing a click handler for the sign-in button
2025-02-20 feat: add test data attribute to concept completed modal sign-in button
    Add a data test attribute to the sign-in button in the concept completed modal to improve test coverage and support page object interactions. This change facilitates easier element selection in automated tests.
2025-02-20 Switch to using `_empty_notags.html` as FastBoot base page to fix meta tags
2025-02-21 refactor: improve concept completed modal sign-in button handling
    Update the sign-in button click handler to:
    - Rename method for clarity
    - Construct full redirect URL with window origin
    - Simplify comment explaining the backend redirect flow
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2025-02-21 refactor: remove null parameter from initiateLogin method calls
    Update multiple components to call initiateLogin without a null parameter, simplifying login initiation across the application
    [course-idea-card.gts]
2025-02-22 feat: implement loading controller with opacity transitions
    Add a new loading controller in TypeScript to manage the loading
    indicator's visibility. The controller handles the insertion and
    removal of the loading indicator with opacity transitions, ensuring
    a smoother user experience. The previous JavaScript implementation
    is removed to improve type safety and maintainability.
2025-02-22 feat: add concept list and update hero icons
    Introduce a new concept list component and its item representation
    to enhance the track page. Replace the old book icon with an
    outline version and ensure proper rendering of concept details.
    This improves the user interface and provides a clearer
    presentation of concepts.
2025-02-22 feat(routes): add language model handling in catalog and track
    Add support for fetching and managing language models in the
    Catalog and Track routes. Introduce a new promise for languages
    in the Catalog route and update the Track route to retrieve
    languages based on the track slug. This enhances the data
    availability for language-related features and improves
    authentication handling for repository data.
2025-02-22 feat(track): inject FastbootService and adjust language loading
    Inject FastbootService into TrackRoute to handle FastBoot-specific
    logic. Modify the language loading process to prevent build errors
    when running in FastBoot. Ensure the store service is declared after
    FastbootService for clarity and maintainability.
2025-02-22 feat(track-page): update course display and tests
    Remove course card rendering from the introduction and courses
    component. Skip a test for the start track button for logged-in
    users with course progress, pending further implementation.
    Enhance view track tests by adding new concept groups and
    ensuring no loading indicator appears when navigating from the
    catalog page. Adjust styles for better visual consistency.
2025-02-22 refactor(tests): streamline track page acceptance tests
    Remove redundant test scenarios and leaderboard entries
    from multiple acceptance tests for the track page.
    Consolidate setup logic in the `beforeEach` hook to
    improve test clarity and reduce duplication.
    Ensure that the tests remain focused on their specific
    assertions while maintaining necessary data setup.
2025-02-25 feat(header): update header links for unauthenticated users
    Refactor header component to include a 'Pricing' link instead of an
    'Upgrade' button for unauthenticated users. Introduce a new method
    to check for link visibility and update the acceptance test to
    validate
2025-02-25 feat(track-page): update start track button logic
    Refactor the start track button to handle user authentication
    more effectively. The button now checks if the user is
    anonymous and whether a primer concept group exists. If the
    user is anonymous and no primer concept group is present,
    it initiates a login. Otherwise, it transitions to the
    appropriate concept or course. Update the button label to
    "Start Learning" for clarity. Enhance acceptance tests to
    cover new scenarios for anonymous users.
2025-02-25 fix: update reference to language property in template
    Update the reference to the `language` property in the
    `start-track-button.hbs` template to use the correct
    context variable. This change ensures that the button
    displays correctly based on the user's authentication
    status and the presence of a primer concept group.
2025-02-25 feat(pay): update login flow and button text for clarity
    Refactor the login process to redirect users to the catalog page after
    initiating login, enhancing user experience. Update button text to
    reflect the action of trying a free project for unauthenticated users,
    and adjust tooltips accordingly. Modify acceptance tests to ensure
    correct behavior and messaging throughout the pay page.
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2025-02-28 tests: remove sign-in button test from concept completed modal
    Remove the sign-in button test from the concept completed modal, simplifying the test suite and removing unnecessary redirection checks
2025-03-12 chore(deps): bump @rails/actioncable from 8.0.1 to 8.0.200
    Bumps [@rails/actioncable](https://github.com/rails/rails) from 8.0.1 to 8.0.200.
    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
2025-03-24 fix(course-progress): filter out private courses from participation groups
2025-03-24 fix(join-track): filter out private courses from course list
2025-03-24 fix(track): exclude private courses from course listing
2025-03-24 fix(course-extension-ideas): filter out private courses from course extension ideas
2025-03-24 test(view-track): add tests to verify that private challenges are not displayed in track view
2025-03-25 test(course-page): add pauses in complete challenge acceptance test for debugging
    Inserted pauseTest calls in the complete challenge acceptance test to facilitate debugging and ensure proper flow during course completion verification. This helps in observing the state of the application at critical points in the test.
2025-03-25 fix(tab-list): update tab visibility based on course visibility and stage conditions
2025-03-25 fix(action-button-list): update button visibility based on course stage and visibility
2025-03-25 fix: adjust visibility logic for code examples button in private courses
2025-03-26 fix: update labels for attempt and completion rates
    Simplify the labels in the course stage participation analysis model
    by changing "attempt rate" to "attempt" and "completion rate"
    to "complete." This enhances clarity and maintains consistency
    in the terminology used across the metrics.
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2025-03-31 refactor: update billing status logic by removing feature flag checks for Stage 2 completion discounts
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2025-04-01 fix(course): update sort order for track slugs
    Adjust the order of track slugs in the CourseModel to prioritize
    'http-server'. This change ensures that 'http-server' appears
    before 'redis', improving the logical flow of the course
    presentation.
2025-04-04 feat: add completed step notice and refactor overlay
    Add a CompletedStepNotice component to the current step complete
    overlay, conditionally rendering it when the modal is dismissed.
    Refactor the overlay component for improved structure and clarity,
    ensuring better management of the instructional and feedback prompts
    while preserving the existing functionality. This enhances user
    experience by streamlining content presentation and focusing on
    important feedback.
2025-04-04 refactor: update comments for clarity in overlay component
    Revise comments in the `current-step-complete-overlay` HBS file to ensure
    clearer guidance on visibility during modal insert and dismissal. This
    improves understanding of functionality related to confetti behavior
    and user experience.
2025-04-04 feat: update current step complete modal layout and styles
    Refactor the layout of the current step complete modal to enhance
    visual hierarchy and responsiveness. The component now centers the
    completion message and adjusts spacing for a cleaner presentation.
    The button size is increased, and the closing button gains margin
    to improve usability. This improves the overall user experience
    and accessibility of the modal.
2025-04-04 feat(course-page): add current step complete modal interaction
    Implements the current step complete modal to enhance user
    experience during course progression. Adds the clickable action
    to navigate to the next step and updates corresponding tests.
    Ensures header accurately displays the current and next
    step after completing the current stage. This change streamlines
    navigation and improves feedback on course progress.
2025-04-04 fix(tests): update completion message assertions in tests
    Refactor acceptance tests for course page to assert on the correct
    completion message displayed in the current step complete modal. This
    ensures that the tests accurately reflect the current implementation
    and improve the reliability of the acceptance tests.
2025-04-04 test: update assertions for complete stage modal visibility
    Change the assertions in the complete second stage test to
    verify the visibility of the current step complete modal instead
    of the completed step notice. This improves clarity regarding
    which UI component is displayed upon completion.
2025-04-04 fix(tests): update next step button click in completion test
    Adjusts the click action in the enable extensions after completion
    test to use the new method for clicking the next step button. This
    ensures the test accurately reflects the current implementation and
    maintains the integrity of the acceptance tests.
2025-04-04 test: update assertion for completion message on course page
    Refactor the test assertion to check for the completion message in the
    current step complete modal instead of the footer text. This improves
    the accuracy of the test by ensuring it validates the correct element
    for the completion status.
2025-04-04 feat(tests): update step completion assertions to use modal
    Update test assertions to verify the visibility and text of the
    current step completion modal instead of the completed step notice.
    This change aligns the tests with the updated user interface elements
    and ensures accurate verification of the stage completion feedback.
2025-04-04 feat(course-page): refactor modal behavior and test improvements
    Import necessary services and utilities in the
    base-stages-completed-card component. Update
    modal handling in templates to use a method for
    closing the modal, enhancing the code readability.
    Add tests for new button interactions within the
    current step complete modal. Adjust assertions in
    acceptance tests to refine testing processes and
    ensure navigation correctness after user actions.
2025-04-04 feat: enhance share progress flow and clean up tests
    Implements the ability to click on the "View Instructions" button in
    the current step complete modal to streamline the sharing progress
    experience. Removes unused imports in related test files for better
    clarity and consistency. Adds TODO comments to indicate future
    improvements for handling the share progress flow more effectively.
2025-04-04 chore(deps-dev): bump ember-svg-jar from 2.6.0 to 2.6.2
    Bumps [ember-svg-jar](https://github.com/voltidev/ember-svg-jar) from 2.6.0 to 2.6.2.
    dependency-version: 2.6.2
    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
2025-04-04 refactor: update button size and adjust text class
    Remove the large size attribute from the PrimaryLinkButton
    to streamline the button's appearance. Change the text class
    of the instructions button to text-xs for better visual
    consistency. These modifications enhance the UI design and
    usability of the components on the course page.
2025-04-05 fix(header): update condition for step progress indicator
    Refactor the conditional logic for displaying the step progress
    indicator to ensure it shows only when the current step status
    is neither "complete" nor "in_progress". This enhances the
    clarity of the displayed information on the course page.
2025-04-06 feat(course-page): add tests passed modal to course stage
    Introduce a new modal component that informs users when they have passed
    all tests for a course stage. The modal provides a celebratory message,
    encourages progression to the next step, and offers an option to view
    instructions again. Additionally, integrate this modal into the current
    step overlay within the course stage template for improved user feedback
    and navigation.
2025-04-06 feat: update success message in tests-passed modal
    Replace the success message to clarify the action of marking the
    stage as complete instead of simply indicating all tests are passed.
    This change improves user guidance and enhances the overall
    clarity of the user interaction.
2025-04-06 feat(tests-passed-modal): add action buttons for stage completion
    Adds two action buttons to the Tests Passed Modal for marking the stage
    as complete and refactoring code. This enhances user interaction by
    providing clear options directly within the modal. Each button has
    associated icons, titles, and descriptions for improved usability.
    Additionally, it updates the layout margins for better spacing.
2025-04-06 feat: add choose action step in tests passed modal
    Introduce a new component to the tests passed modal, allowing users
    to choose between actions: marking the stage as complete or
    refactoring code. Enhance accessibility with data-test attributes
    for better integration with tests. Update related test files to
    accommodate the new structure, ensuring consistent user interactions.
2025-04-06 feat: enhance tests passed modal with loading state
    Update the action button to display a loading spinner when processing.
    Add an isProcessing flag for better UX. Modify the ChooseActionStep to
    pass down the new flag. Refactor the command variant component to accept
    additional attributes. These changes improve user feedback during
    asynchronous actions and enhance component reusability.
2025-04-06 refactor: simplify instructions for test runner card
    Remove redundant component files and simplify the user
    interface for managing code instructions. The code now
    directly presents the command options based on the current
    step, improving maintainability and user experience. The
    refactor consolidates logic and reduces unnecessary
    component complexity, streamlining the rendering process.
2025-04-06 refactor: move course stage completion logic to service
    Update `TestsPassedModal` to use a new `CourseStageCompletionService`
    for handling the creation of course stage completions. This change
    removes the local task definition, centralizing the logic for better
    maintainability and testability. Pass the current step to the modal,
    ensuring the required data is available for processing actions.
2025-04-06 test: update course page tests for modal interactions
    Replace deprecated test runner card checks with tests passed modal
    assertions. Confirm visibility and titles of the tests passed modal.
    Ensure proper interaction flow by clicking the action button in the
    tests passed modal. These changes enhance the clarity and accuracy
    of the acceptance tests.
2025-04-06 refactor: update button types and argument handling
    Change button elements to specify type="button" for clarity. Update
    component argument references in templates to use shorthand @syntax
    for consistency. Remove unused imports in tests to streamline code.
    These changes improve code readability and maintainability.
2025-04-06 test: update assertions for test runner card visibility
    Refactor the acceptance tests for the course page to validate the
    visibility of the test runner card instead of its border color.
    Remove the outdated check for the 'borderIsTeal' property and
    assert that the test runner card is visible or not based on the
    test results. This change improves the accuracy of the test
    assertions and aligns them with the current UI state.
2025-04-06 style: enhance dark mode support for action button
    Update the styling of the action button for improved dark mode
    compatibility. Adjust the button's gradient and text colors to ensure
    visibility and maintain consistency across themes. This change aims
    to enhance user experience for those utilizing dark mode.
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2025-04-07 Greyed out released stuff and try adding a test(?)
    [course-idea-card.gts]
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2025-04-18 Fix possible null-reference when reading `router.currentRoute.metadata`
2025-04-22 feat: update course-related logic to include 'gleam-chess-bot-js' in visibility conditions for action buttons and tabs
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2025-04-28 Dark mode on /vote
    [course-idea-card.gts, submit-course-idea-card.gts, unvote-button.gts, vote-button.gts]
2025-04-29 Removed popping and shadows
    [course-idea-card.gts, submit-course-idea-card.gts, vote-button.gts]
2025-05-01 feat: add feedback section with upvote/downvote functionality refactor(feedback): increase animation duration for voting feedback fix: improve feedback section text clarity and consistency feat: add 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
2025-05-06 refactor: enhance optimistic UI feedback for upvote and downvote buttons in feedback section
2025-05-06 refactor: simplify button class handling for upvote and downvote actions in feedback section
2025-05-06 refactor: add 'unvote' endpoint to handle removal of user votes on community course stage solutions
2025-05-06 test: enhance vote button interactivity by adding inactive state assertions in acceptance tests
2025-05-08 test: update vote acceptance tests to clarify downvote functionality and assert button states
2025-05-08 refactor: conditionally render feedback section based on current user to prevent self-voting
2025-05-09 fix: update statistic labels in stage list item component
2025-05-09 feat: implement CodeExampleInsightsIndexController to manage language selection and display course stages with analyses
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2025-05-13 feat: update stage statistics to conditionally display values based on community solutions analysis
2025-05-13 feat: implement method to create empty community solutions analysis and enhance stage analysis retrieval logic
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2025-05-14 feat: update code example insights template to conditionally display stages based on selected language
2025-05-14 feat: enhance code example insights template to display stages conditionally based on selected language and improve no stages found messaging
2025-05-14 feat: add target attribute to stage list item link for opening in a new tab
2025-05-14 refactor: remove unused analysis linking logic and streamline stagesWithAnalyses computation in CodeExampleInsightsIndexController
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2025-05-16 feat: add highlightedFiles attribute to course stage solution model and data structure
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2025-05-30 feat: enhance course solution metadata tracking
    Add `highlightedLinesCount`, `addedLinesCount`, and `removedLinesCount`
    attributes to track solution changes effectively. Update the `changedLinesCount`
    getter to return the sum of added and removed lines using the new attributes.
    Include highlighted lines count in the insights display for better visibility
    of code modifications.
2025-05-30 feat: add flakiness check status to course stage solution
    Adds a new `flakinessCheckStatus` attribute to the
    `CommunityCourseStageSolution` model, representing different
    states of the flakiness check. Implements a computed property
    to format flakiness check status messages in the metadata
    container, enhancing user feedback and visibility on the
    flakiness checks associated with course solutions.
2025-05-31 fix: update community solution card logic for highlighted files
    Refactor the logic for displaying highlighted files in the community
    solution card. Remove the dependency on the current user being staff
    for the presence of highlighted files to ensure compatibility with
    solutions that may not have been migrated yet. Update the template
    to directly check the length of highlightedFiles, improving code
    clarity and maintaining proper functionality across variations of
    solutions.
2025-05-31 feat(tests): add highlighted file cards to code examples page
    Adds a new collection for highlighted file cards within the code examples
    page. Updates the publish-to-GitHub test to interact with the new
    highlighted file cards instead of the deprecated changed file cards.
    These changes enhance the test's accuracy and ensure it reflects the
    current UI layout and functionality.
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2025-06-05 refactor: enhance FAQ layout and spacing in templates
    Remove redundant header from FaqList component and move the title
    to the parent template. Adjust spacing for FaqList and
    TestimonialList to improve layout consistency and visual flow.
    These changes create a cleaner presentation of the FAQ section
    and better align the elements on the page.
2025-06-05 feat: add Instagram company logo SVG asset
    Add SVG asset for the Instagram company logo to enhance brand
    representation. This change provides a scalable vector format
    for optimal display across different screen sizes and devices.
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2025-06-12 feat(logo): update Next.js company logo to new design
    Replace the existing Next.js company logo SVG with a new
    design that better reflects the branding and visual style.
    This change enhances the overall aesthetic and ensures
    alignment with current brand guidelines.
2025-06-17 refactor(view-leaderboard-test): simplify assertion for default leaderboard entries
    - Update the assertion in the view-leaderboard test to clarify that no entries should be present by default, removing the team selection logic from the test case.
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2025-06-19 refactor(billing-page): update invoice handling to use receipt URL
    - Changed the invoice download link to use the receipt URL instead of the invoice ID.
    - Updated the link text from "Download Invoice" to "View Invoice" for clarity.
    - Removed the obsolete invoice download URL method from the Charge model.
2025-06-20 feat(vote-page): remove Glint error comments and add type declarations
    [course-idea-card.gts, submit-course-idea-card.gts]
2025-06-23 Rename /vote -> /roadmap + redirect to support old
    [course-idea-card.gts, submit-course-idea-card.gts, unvote-button.gts, vote-button.gts]
2025-06-23 Ehh stage again?
    [course-idea-card.gts, submit-course-idea-card.gts, unvote-button.gts, vote-button.gts]
2025-06-23 Linter my dear friend
    [submit-course-idea-card.gts, unvote-button.gts, vote-button.gts]
2025-06-25 refactor: rename development status label to pill in tests and UI
    [course-idea-card.gts]
2025-06-28 Implemented Paul's Comments
    [course-idea-card.gts, vote-button.gts]
2025-07-02 Pass tests + Keep Released for now
    [course-idea-card.gts]
2025-07-02 brighter vote count in dark mode
    [course-idea-card.gts]
2025-07-02 brighter vote buttons in dark mode
    [vote-button.gts]
2025-07-02 brighter vote counts on dark mode
    [course-idea-card.gts]
2025-07-20 Add `border-gray-200` to all elements with `border-*` where border color isn't specified
    [submit-course-idea-card.gts]
2025-07-20 Replace all usages of `flex-shrink` with `shrink`
    [course-idea-card.gts]
2025-07-20 Replace all usages of `flex-grow` with `grow`
    [course-idea-card.gts]
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2025-07-20 Fix class specificity for buttons overriding default `display: inline-block` property [percy]
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2025-07-30 chore(deps-dev): bump ember-svg-jar from 2.6.2 to 2.6.3
    Bumps [ember-svg-jar](https://github.com/voltidev/ember-svg-jar) from 2.6.2 to 2.6.3.
    dependency-version: 2.6.3
    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
2025-08-04 feat(subscription): replace currentPeriodEnd with cancelAt
2025-08-05 fix: reorder http-server in track sort position list
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2025-08-12 Remove `Component` ending from all component classes It was removed from default blueprint in ember 5.11: https://github.com/emberjs/ember.js/pull/20704
    [course-idea-card.gts, submit-course-idea-card.gts, unvote-button.gts, vote-button.gts]
2025-08-12 feat(mirage): add new handlers for charges, code walkthroughs, and community solution evaluators
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2025-08-14 Initiate Login on Campus Claim Offer Button for Non Logged in chaps
2025-08-14 Add a FIXME to `no-array-prototype-extensions` eslint rule When set to `warning` - it causes `npm run lint --fix` to do crazy things...
2025-08-16 Add test for claim offer button redirecting to login if user is not signed in
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2025-08-21 Refactor campus program application modal to handle email already in use case.
2025-08-22 Fix default value of isOverridingSavedGrantApplication and filter applications by status
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2025-08-24 Refactor email address retrieval to use currentUser in CampusProgramApplicationModal
    Add belongsTo relationship for user in EmailAddressModel
    Add hasMany relationship for emailAddresses in UserModel
    Include user in email-address fetch in InstitutionRoute
    Update claim-offer-test to associate email address with user correctly
2025-08-27 chore(deps): bump @rails/actioncable from 8.0.200 to 8.0.201
    Bumps [@rails/actioncable](https://github.com/rails/rails) from 8.0.200 to 8.0.201.
    dependency-version: 8.0.201
    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
2025-08-27 feat(language-dropdown): enhance button layout and logo display style: add margin to language dropdown logos for spacing fix: increase icon and image size in language dropdown
2025-09-03 feat(language): update track learners count data
    Update the track learners count with the most recent statistics
    as of September 1, 2025. This change reflects the latest
    figures for various programming languages to ensure accuracy
    in reporting and analytics.
2025-09-03 feat: add scoreUpdatesCount to leaderboard entry model
    Adds a scoreUpdatesCount attribute to the leaderboard entry model to
    track the number of times a score has been updated. Updates the row
    component to display scoreUpdatesCount instead of score for better
    clarity on user score progression. Fixes the comparison operator in
    isCurrentUser getter for strict equality.
2025-09-03 feat: refactor leaderboard entries table for better structure
    Refactor the leaderboard entries table component to enhance its
    structure and usability. Introduce a new `HeaderRowCell` component
    for header cells to encapsulate alignment and tooltip explanations.
    Pass the `language` model to the `EntriesTable` and use it to
    generate descriptive markdown for completed stages and scores.
    Reorganize the rendering of table headers for clearer code.
2025-09-03 fix: reorder getters for leaderboard entries
    Reorganize the code by moving the `sortedTopEntries` getter
    below the `sortedSurroundingEntries` getter for better
    readability and logical flow. This change enhances the
    structure of the leaderboard page component.
2025-09-04 feat: simplify leaderboard entries filtering logic
    Remove unnecessary error checks for filter type in the
    leaderboard entries handler. Update the filtering logic
    to handle the absence of a filter type, defaulting to
    returning the top entries when no type is specified.
2025-09-04 feat(leaderboard): fix ranking logic and remove banned entries
    Refactor entries-table component to filter out banned entries before
    sorting surrounding and top leaderboard entries, ensuring accurate rank
    calculations. Move userEntryIndexInSurroundingEntries getter below sorted
    entries to fix the reference order. Also update the post handler in
    mirage server to remove unused request parameter for clarity and update
    ranking date and static rank assignment.
2025-09-04 fix(contest): pass current user ID in leaderboard query
    Add user_id parameter to leaderboard query in contest route to
    support tests relying on current user context. This change ensures
    test scenarios can simulate authenticated user behavior since
    Mirage lacks an auth context.
2025-09-04 fix(leaderboard): return serialized empty response for missing user
    Change the response for missing user leaderboard entries from an
    empty array to an object with a data key containing an empty array.
    This ensures consistent serialization output and avoids issues with
    the current serialize method not handling empty arrays properly.
2025-09-04 test(acceptance): add language switch test on leaderboard page
    Refactor leaderboard page test helper by extracting language dropdown
    into its own component and enhancing entries collection to include
    username text. Add a new acceptance test to verify that users can
    switch between Rust and Python leaderboards, ensuring the URL updates
    correctly and leaderboard entries reflect the selected language.
    This improves test coverage for multi-language support and ensures UI
    correctness when changing the leaderboard language.
2025-09-05 test(acceptance): refactor leaderboard entry setup into helper
    Add a new helper function to create leaderboard entries from sample data,
    reducing duplicate test setup code for both anonymous and authenticated
    user scenarios. Introduce a new test to verify leaderboard page viewing
    for anonymous users. This improves test clarity and maintainability.
2025-09-05 feat(leaderboard): show accurate stage counts and add header explanations
    Replace all uses of stagesCount with liveOrBetaStagesCount to reflect only
    live or beta course stages. This improves accuracy of displayed stage numbers
    across leaderboard and track cards.
    Move stage count and score explanation tooltips into a dedicated header row
    component for better structure and reusability.
    Update header cells to display explanations for "Stages Completed" and "Score"
    to clarify scoring and stage availability to users.
2025-09-05 refactor(language): centralize liveOrBetaStagesCount logic
    Move liveOrBetaStagesCount getter to the Language model and update
    templates and components to use this centralized property. Remove
    duplicate stagesCount logic from TrackCard component.
    Fix LeaderboardPage EntriesTable to use correct language argument.
    These changes improve data consistency by deriving stage counts in one
    place and simplify component code.
2025-09-09 refactor(danger-button): update hover and progress bar logic
    Replace isHovered state with shouldShowProgressBar to manage progress visibility. Simplify event handling by removing mouse enter/leave actions and adding touch event support. This enhances user interaction and improves code clarity.
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2025-09-09 fix(danger-button): correct event handling comment for touchend trigger
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2025-09-09 refactor(danger-button): update progress handling logic to use resetProgress method
    Replace stopProgress method with resetProgress to streamline progress bar management. This change enhances event handling for mouse and touch interactions, ensuring consistent behavior across different input types.
2025-09-09 fix(leaderboard): load user data only when user is off top list
    Avoid loading user-specific leaderboard entries and rank
    calculations if the user is already in top leaderboard entries.
    Also, handle case when no surrounding entries are found,
    skipping unnecessary data fetches.
    Add validation in Mirage handler to ensure user exists,
    leaderboard exists, and user has a leaderboard entry before
    creating rank calculations.
    Add acceptance test for authenticated users without leaderboard
    entries to ensure proper handling and UI rendering.
2025-09-09 feat(leaderboard): add loading skeleton and simplify data flow
    Add a skeleton row component with animated placeholders to improve UX
    during leaderboard data loading. Refactor EntriesTable to accept loading
    state and all relevant data as args, removing internal fetching and
    tracked state management. Update loading skeleton styles for better
    visual feedback. These changes decouple data loading from the table
    component and provide a smoother loading experience.
2025-09-10 fix(contest): exclude new leaderboard entries from top results
    Filter out newly created (unsaved) leaderboard entries from the top
    leaderboard results to prevent temporary entries from affecting the
    display. Add a TODO to reconsider using `query` instead of
    `adapterOptions` or implement explicit caching for better handling.
2025-09-10 test: exclude leaderboard API requests from count filters
    Add exclusion for '/api/v1/leaderboard-entries/for-current-user' in API
    request filtering logic within test helpers. This prevents counting
    requests triggered during header rendering, improving accuracy of API
    request count assertions in tests.
2025-09-10 fix(models): allow nullable language on LeaderboardModel
    Change the language relation on LeaderboardModel to be nullable to handle
    cases where a leaderboard may not have an associated language. Update the
    preferred-language-leaderboard service to filter out leaderboards with
    null languageId and safely access the language slug. This prevents runtime
    errors and ensures that only valid leaderboards are considered for the
    preferred language leaderboard calculation.
2025-09-10 feat(user): add fetchTopLanguageLeaderboardSlugs API and mirage handler
    Add a new member action fetchTopLanguageLeaderboardSlugs to the UserModel
    to retrieve the top language leaderboard slugs for the current user. This
    enables fetching the top 3 language leaderboards where the user has the highest
    scores.
    Implement a corresponding MirageJS handler to support this endpoint for
    development and testing, returning sorted and filtered leaderboard slugs based
    on the current user's leaderboard entries.
    Fix swapped implementations of fetchCurrent and fetchNextInvoicePreview actions
    to correctly match their respective API endpoints and return types.
2025-09-10 refactor: remove unused imports in leaderboard handlers and services
    Remove the unused import of CurrentMirageUser in the leaderboard-entries
    mirage handler and LeaderboardEntryModel in the preferred-language-leaderboard
    service to clean up the codebase and improve maintainability.
2025-09-10 feat(leaderboard): prioritize preferred languages in dropdown
    Update sortedLanguagesForDropdown to display the user's preferred
    languages first, followed by all other languages sorted by track
    position. This improves user experience by highlighting relevant
    languages based on user preferences. Inject PreferredLanguageLeaderboardService
    to access preferred language slugs for this ordering.
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2025-09-16 feat(roadmap): always show RoadmapInfoAlert on all screen sizes
    Remove the "hidden md:block" classes from RoadmapInfoAlert components
    to ensure the informational alerts about challenges and extensions are
    visible on all screen sizes. Also, update RoadmapInfoAlert to forward
    HTML attributes to the underlying Alert component for better flexibility.
    These changes improve user awareness of roadmap concepts regardless of
    device or viewport.
2025-09-16 test: remove deprecated earn-badge test and related badge UI
    Remove the acceptance test for earning badges on the course page
    and all associated UI components, badge data fetching, and page
    elements. These changes simplify the course stage instructions and
    repository poller by eliminating badge award logic and cleanup
    unused code. This cleanup reflects a shift away from badge earning
    notifications in the UI to reduce test complexity and maintain code
    clarity.
2025-09-17 feat(course-page): show language leaderboard rank on stage completion
    Display the user's leaderboard rank for the repository language when completing
    a CourseStageStep. Hide the generic completion notice for stage steps and
    replace it with a detailed LanguageLeaderboardRankSection.
    Update the Mirage handler to use the current authenticated user and calculate
    the correct leaderboard rank dynamically. Include the language leaderboard
    relationship during repository polling to support these enhancements.
    This provides users with immediate feedback on their ranking progress after
    completing significant course stages, improving engagement and motivation.
2025-09-17 test: add language leaderboard visibility checks in course stage modal
    Add assertions to verify the language leaderboard rank section visibility
    within the current step complete modal across multiple acceptance tests.
    Refactor tests to click the "View Instructions" button before checking the
    completion message to better simulate user interaction.
    Introduce a data attribute to the leaderboard section for reliable test
    targeting. Update page object selectors to reflect this change for cleaner and
    more maintainable test code. This improves test coverage and aligns assertions
    with updated UI behavior.
2025-09-17 test: improve assertions for language leaderboard visibility
    Update acceptance tests to explicitly check that the language
    leaderboard rank section is visible in the current step complete modal
    across multiple course page stages. Remove redundant clicks on the
    view instructions button to streamline test flow and focus on verifying
    key UI elements related to stage completion and feedback prompts.
2025-09-17 feat(current-step-complete-modal): show leaderboard rank conditionally
    Refactor completion modal to display the language leaderboard rank
    section only when feature flag is enabled and current step is a stage.
    Move completion notice message to the else case to avoid duplication
    and remove the previous unused unless block. This ensures the UI
    adapts based on feature flags for a better user experience.
2025-09-17 test: enable leaderboard feature flag in acceptance tests
    Update acceptance tests for course page to enable the leaderboard
    feature flag on the current user. This ensures the language leaderboard
    rank section is visible during tests and aligns test behavior with the
    feature being behind a flag.
    Refactor user assignment to use returned currentUser from signIn methods
    for clarity. Add a pause in one test to aid debugging.
    Add TODO comments to remove these flag updates once the leaderboard
    feature is fully launched.
2025-09-17 Refactor track-page tests to ensure correct sorting of courses by submission date.
2025-09-17 style: add dark mode support to track and concept group sections
    Update border and text colors to include dark mode variants, ensuring
    consistent styling in dark themes for track page and primer concept group
    section components. Improve hover border behavior for better visual
    feedback when concept lists are collapsed in dark mode.
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2025-09-26 feat(gifts): add gift payment flow with multi-step navigation
    Introduce a new gift payment flow feature under /gifts/buy route that
    supports creating or fetching a gift payment session. Implement a
    multi-step navigation component to guide users through the gift
    purchase process, tracking completed and current steps within the
    controller. Add data model for gift payment flow to store user inputs,
    and create corresponding page objects for easier testing and interaction.
    These changes enable anonymous access and enhance user experience by
    providing clear navigation and state management throughout the payment
    steps.
2025-09-26 feat(gift-payment-page): add choose-plan and confirm-pay steps
    Introduce ChoosePlanStepContainer for selecting a pricing plan,
    defaulting to yearly if current selection is invalid. Add
    ConfirmAndPayStepContainer to handle payment confirmation with
    processing state and error handling. Update test helpers to support
    new UI steps. These changes enable a multi-step gift purchase flow
    with plan selection and payment processing.
2025-09-26 fix(gift-payment-page): await saving gift payment flow task
    Ensure the saveGiftPaymentFlowTask waits for the save operation to
    complete by adding await. This prevents potential race conditions and
    ensures data consistency during the gift payment process.
2025-09-26 fix(gifts): correct import of fade transition in buy controller
    Change the import of the fade transition from a named import to a default
    import in the GiftsBuyController. This fixes an issue with the transition
    not working correctly, ensuring smooth animations on the gift purchase flow.
2025-09-26 feat(gifts): set default pricingPlanId for new gift payments
    Set the default pricingPlanId to 'v1-lifetime' when creating a new
    gift-payment-flow record. This ensures that new gift payments have a
    consistent default pricing plan, improving data consistency and
    reducing potential errors in payment processing.
2025-09-26 feat(gift-payment): add saving state and concurrency to form steps
    Introduce ember-concurrency tasks to handle saving gift payment flow data
    when selecting plans or submitting details. Track saving state with `@tracked`
    properties and disable continue buttons during save operations. Update button
    labels to show "Saving..." spinner for better user feedback. Validate form input
    on blur and submit, saving data only when inputs are valid. These changes improve
    UX by providing clear feedback and preventing duplicate submissions.
2025-09-26 feat(gift-payment): add navigation and improve UI in payment flow
    Introduce onNavigationItemClick callback to ConfirmAndPayStepContainer to
    enable users to navigate back to previous steps via clickable "change"
    buttons. Update templates to use animated container with smooth transitions
    between steps for better UX. Display selected plan price in ChoosePlanStep
    and add selectedPlan getter for cleaner access to current plan details. These
    changes improve navigation clarity and overall user experience in the gift
    payment process.
2025-09-26 feat(gift-payment): add checkout session generation and redirect
    Add API endpoint to generate Stripe checkout sessions for gift payments.
    Implement model action to call this endpoint and trigger checkout session.
    Update payment step to create session and redirect user to Stripe checkout.
    Add acceptance test to verify redirection to the Stripe checkout URL.
    These changes enable processing gift payments via Stripe Checkout,
    improving the payment flow by integrating session creation and navigation.
2025-09-26 fix: rename payment processing flag for clarity in pay button
    Rename `isProcessingPayment` to `isProcessingPayButtonClick` to more
    accurately reflect that the flag tracks the pay button click processing
    state. Update the button's disabled state, spinner visibility, and
    loading text accordingly. This improves code readability and ensures
    the UI shows "Saving..." during payment submission.
2025-09-26 feat(gift-payment): enable fetching and revisiting existing flows
    Uncomment the GET endpoint for /gift-payment-flows/:id to support fetching
    an existing gift payment flow. Add a new acceptance test to verify that
    users can revisit an existing payment flow with pre-populated form data.
    Enhance the gift payment page object to expose input values for sender email
    and gift message, enabling assertions on pre-populated fields during tests.
2025-09-26 refactor(test): remove unused waitUntil import in purchase test
    Remove the waitUntil import from purchase-test.js as it is not used
    within the test suite. This cleans up the code and avoids unnecessary
    dependencies in the acceptance tests for the buy-gift-page purchase flow.
2025-09-26 refactor(payment): update checkout session URL keys
    Change successUrl and cancelUrl keys to 'success-url' and 'cancel-url'
    to align with backend API expectations. Adjust related component code
    to pass the new keys when generating the checkout session. This ensures
    correct URL handling for payment success and cancellation flows.
2025-09-26 fix(gift-payment-flows): validate required URLs in checkout session
    Add explicit validation to ensure 'success-url' and 'cancel-url' are
    provided in the request body when generating a checkout session.
    This prevents incomplete requests and potential errors during payment
    flow handling in the mock server.
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2025-09-28 chore(config): bump major version to 37.0 to force updates
    Update the app version from 36.0 to 37.0 in environment.js to ensure
    all clients receive the latest changes. This forces a full update
    since the minor version is currently unused.
2025-10-02 docs: add comprehensive test file formatting guidelines
    Introduce detailed rules for structuring test files, including import
    ordering, module declarations, setup functions, and test case patterns.
    Define conventions for page object files and components to ensure
    consistency and maintainability across the codebase.
    These guidelines improve readability and enforce best practices in
    writing and organizing tests.
2025-10-02 docs: update development workflow testing instructions
    Clarify how to run tests during development by removing
    command-line instructions and replacing them with guidance
    to use the browser-based test runner. Emphasize avoiding slow
    npm scripts and highlight how to view test results and console
    errors in the browser. This aligns the workflow with current
    best practices and improves developer experience.
2025-10-02 feat(gifts): add redeem gift feature with route and tests
    Add a new route for redeeming gifts using a secret code at
    /gifts/redeem/:secret_code. Implement a basic route and controller
    setup for the redeem page to support future gift redemption logic.
    Create page objects and acceptance tests to verify navigation to
    the redeem page works correctly with different secret codes.
    This lays the groundwork for implementing gift redemption flows.
2025-10-02 feat(gifts): implement gift redemption model and redirect on invalid code
    Add MembershipGift model with associations and attributes to represent gift
    data. Update GiftsRedeemRoute to fetch a membership gift by secret code,
    redirecting to not-found if no gift is found. Fix acceptance test to use
    currentURL helper for correct URL assertion. These changes enable the gift
    redemption feature and improve route handling for invalid codes.
2025-10-02 feat(gifts): implement gift redemption page and logic
    Add a redeem gift page showing gift details with claim button, and
    declare the model type in the controller for better type safety. Update
    the route and model hooks to use 'secret_token' instead of 'secret_code'
    for consistency. Enhance tests to cover gift details display and 404
    redirect when a gift is not found. Add mirage handler for membership gifts
    to support testing. This enables users to redeem their CodeCrafters
    membership gifts with proper validation and user feedback.
2025-10-02 feat(gifts): enhance redeem button functionality and add tests
    Update redeem button to handle user states: disable for users with
    existing membership, show loading state during redeem, and trigger
    GitHub login for anonymous users. Add contextual tooltips explaining
    button state and actions. Introduce acceptance tests covering
    redeem button behavior for anonymous users and those with active
    memberships to ensure correct UI feedback and enablement.
2025-10-02 feat(gifts): add redeem action and improve redeem UI state
    Add a redeem member action to MembershipGiftModel that posts to the
    redeem endpoint, enabling gift redemption via the API.
    Update the gifts redeem controller to disable the redeem button while
    a redemption is in progress to prevent duplicate submissions.
    Implement actual redeem logic by calling the model's redeem action and
    redirecting to the catalog on success.
    Improve error handling by rethrowing caught errors and resetting the
    redeeming state accordingly.
2025-10-03 Update gap size in extension card layout and adjust structure for toggle button.
2025-10-03 Fix progress pill type check to ensure stages array is not empty before evaluation.
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2025-10-07 fix(course-stage-step): remove unnecessary collapse prop from card
    Remove `@isCollapsedByDefault={{true}}` from YourTaskCard component in
    the CourseStageStep to simplify the card behavior. This change ensures
    the card is always expanded by default, improving user visibility and
    interaction.
2025-10-07 refactor(instructions): remove temporary help forum CTAs
    Remove the conditional display of help forum call-to-actions in stage
    1 and stage 2 for the "shell" course. These CTAs were intended as
    temporary aids to guide users to support channels and gather feedback.
    Cleaning up the interface improves focus on the core content and reduces
    visual clutter now that these temporary measures are no longer needed.
2025-10-07 refactor(your-task-card): extract header into a dedicated component
    Move the header section from the YourTaskCard template into a new
    YourTaskCard::Header component to improve code organization and readability.
    The header now receives currentStep as an argument and handles rendering
    the task title, step status pill, feedback button, edit link, and difficulty
    label separately, reducing complexity in the main component.
2025-10-07 refactor(course-stage): move instruction rendering logic
    Extract instruction markdown rendering to a new method on the course stage
    model. This centralizes the template rendering logic and removes the direct
    Mustache dependency from the YourTaskCard component. The change improves code
    organization by keeping related logic closer to the data model and simplifies
    the component code.
2025-10-07 test: remove YourTaskCard integration test and add acceptance test
    Remove the integration test for YourTaskCard component to simplify the test
    suite and reduce redundancy. Replace it with an acceptance test that verifies
    all task links open in new tabs within the full user flow. This ensures the
    link behavior is validated in a realistic context and improves confidence in
    the feature without duplicating test coverage.
2025-10-07 refactor(tutorial-card): remove read-instructions step and simplify completion logic
    Eliminate the read-instructions step component and associated markup to
    streamline the second stage tutorial card. Update completion logic to only
    track the implement-solution step, removing redundant state and analytics
    tracking for read-instructions. This reduces complexity and improves UI
    clarity by focusing on the most important step users need to complete.
2025-10-07 refactor(course-overview): simplify activeRepository getter
    Replace complex filtering chain with direct sorting of userRepositories.
    This improves code readability and performance by avoiding multiple
    filterBy calls and creating fewer intermediate arrays. The change keeps
    the logic to return the most recent repository based on lastSubmissionAt.
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2025-10-07 feat(course-stage): refactor first stage task cards and simplify UI
    Remove the FirstStageTutorialCard and replace it by the new
    FirstStageYourTaskCard component to better focus on task instructions
    for the first stage. Consolidate task cards by conditionally rendering
    FirstStageYourTaskCard only for the first stage, and YourTaskCard for
    later stages.
    Simplify the TestRunnerCard usage by always making it collapsible and
    removing the special popover and conditional expand handling for the
    first stage.
    Comment out the PrerequisitesCard temporarily for future revisit.
    These changes improve clarity of instructions for the first course
    stage and streamline UI logic by reducing conditiona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
2025-10-07 feat(course-stage-step): improve first stage your task card
    Update first stage your task card to use currentStep's course stage ID
    instead of courseStage.id for contentIdentifier. Add data-test attributes
    for better test targeting. Fix anchor link target from #first-stage-tutorial-card
    to #first-stage-tutorial-heading for accurate navigation.
    Refactor test page imports and selectors to reflect component renaming and
    updated data-test scope. Remove unused code related to scrolling on first
    stage tutorial card for cleaner implementation.
2025-10-07 refactor(course-stage-step): simplify first stage task steps
    Update the task title to "Git push to submit your changes" for clarity.
    Remove the "navigate-to-file" step and related completion tracking,
    focusing only on the "uncomment-code" step. This simplifies the step
    logic and manual completion handling, improving maintainability.
2025-10-07 fix(course-stage-step): correct step number in analytics event
    Update the completed_first_stage_tutorial_step event to use step_number
    1 instead of 2 to accurately reflect the user's progress in the first
    stage instructions. This ensures correct tracking and analytics data.
2025-10-07 test: update acceptance test to use YourTaskCard component
    Replace all references to firstStageTutorialCard with firstStageYourTaskCard in
    the complete-first-stage-test.js file. This aligns the test with recent UI
    changes where the tutorial card was renamed or replaced by the Your Task card.
    This update ensures the test interacts with the correct elements and verifies
    the intended user workflow accurately.
2025-10-07 fix(course-stage-step): show full instructions markdown on task card
    Remove truncation of instructions markdown in first-stage-your-task-card by
    rendering the complete instructions instead of only the first paragraph.
    This ensures users see all the information needed to pass the stage without
    missing details from the truncated content.
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2025-10-13 feat(course-card): dynamically set route and models for stage links
    Add a computed property to determine the route and models based on stage
    completion and position. Link to the course introduction if the stage is
    the first and incomplete; otherwise, link to stage instructions. This
    improves navigation accuracy and user experience on the track page.
2025-10-14 test(course-page): fix language guide rendering and remove pause
    Update binding context from @languageGuide to this.languageGuide in
    implement-solution-step.hbs to correctly render markdown content.
    Remove unnecessary pauseTest call in language-guides-test.js to improve
    test flow and reliability. These changes ensure the language guide card
    displays accurate content and the acceptance test runs smoothly.
2025-10-14 test: replace yourTaskCard action with header tab click in code examples
    Update acceptance tests to open the Code Examples tab via the header
    navigation link instead of using the yourTaskCard action button. This
    change reflects UI updates and improves test reliability and clarity.
2025-10-14 fix(course-stage-step): pass currentStep as an argument to header
    Update YourTaskCard Header component to receive currentStep via
    argument instead of from coursePageState. This improves component
    flexibility and ensures the current step is explicitly controlled
    from the parent, enhancing maintainability and clarity.
2025-10-14 feat(course): set default course visibility and update screencasts test
    Set the default visibility of created courses to 'public' in the course
    creation utility to ensure consistent course access state. Update the
    acceptance test for the course screencasts page to use a more accurate
    navigation method by clicking the header tab link instead of the task
    card action button, improving test reliability and clarity.
2025-10-15 refactor(course-stage-solution): remove unused explanationMarkdown attr
    Remove the explanationMarkdown attribute and related hasExplanation
    getter as they are no longer needed. This simplifies the model by
    eliminating unused properties and streamlines data handling.
2025-10-15 feat(course): simplify solution creation and refine UI hints
    Return the created course-stage-solution object from the utility to enable
    further chaining or inspection. Remove extraneous dummy changedFiles and
    explanationMarkdown content to reduce clutter and improve data relevance.
    Refactor the solution step component template to conditionally render hints
    from the solution rather than the language guide, and clean up unnecessary
    wrapping elements. Update the step title to clarify the task as writing code
    to pass the stage.
    Remove unused Hint type declarations from the language guide model for cleaner
    code.
2025-10-15 feat(course-page): add hints for second stage user task
    Update hint-card to use CourseStageSolution model instead of
    CourseStageLanguageGuide. Refactor template conditional for hover
    state clarity. Add acceptance test data for second stage with detailed
    hints explaining Python input() and print() usage, improving user
    guidance during the task.
2025-10-15 refactor(course-stage-solution): rename hints to hintsJson for clarity
    Update course-stage-solution model to rename the 'hints' attribute
    to 'hintsJson' to better reflect that it stores free-form JSON data.
    Adjust all related template and test code to use the new property
    name, ensuring consistency and preventing potential confusion.
    Fix wording in second-stage-your-task-card template to improve
    clarity of task description.
2025-10-15 test: remove language-guides acceptance test
    Remove the acceptance test for viewing language guides on the course page.
    This test was removed to reduce maintenance overhead and because it no longer
    reflects the current application behavior after recent UI and API changes.
2025-10-15 refactor: remove deprecated course stage language guides feature
    Remove the SimpleLanguageGuideCard and LanguageGuideCard components,
    along with associated controller actions, Mirage handlers, and API calls.
    This cleanup eliminates the deprecated course stage language guides feature,
    simplifying the codebase and improving maintainability.
2025-10-16 test: improve API request verification in course page tests
    Refactor acceptance tests to verify specific API request sequences
    instead of just counting requests. Replace generic request count with
    detailed expected API endpoints to ensure accurate server communication
    during course page interactions and polling. Remove unused imports to
    clean up page test files. These changes enhance test reliability and
    clarity by explicitly validating API calls triggered by user flows.
2025-10-16 refactor(tests): simplify first stage completion test flow
    Remove redundant assertions and click interactions in the first stage
    completion test to streamline the test and improve maintainability.
    fix(docs): fix whitespace in commit and push instructions
    Correct formatting in the submit-code-step component by removing
    unnecessary line breaks for better readability.
2025-10-16 feat(course-page): add push empty commit step to setup flow
    Introduce a new "Push an empty commit" step in the repository setup card to
    guide users through pushing an initial empty commit. Refactor setup steps
    into a defined step list with individual step components for clearer
    structure and improved extensibility. Update templates to render steps
    dynamically and provide copyable terminal commands for ease of use.
2025-10-16 refactor: remove manual completion tracking from second stage steps
    Remove manual step completion state and related analytics tracking from the
    second stage task card component and course page state service. Simplify the
    logic for determining step completion by relying solely on repository
    submissions and test results. Replace ExpandableStepList with StepList to
    reflect the UI update and streamline step rendering. These changes reduce
    complexity and remove unused code paths for better maintainability.
2025-10-16 test: update second stage completion test for UI and auth changes
    Refactor selector for steps in second-stage task card by replacing the
    expanded-step-list-step with step-list-step and removing isExpanded and
    instructions properties to align with updated component structure.
    Update acceptance test to sign in as a subscriber instead of default user
    to better reflect real use cases.
    Simplify and remove checks related to step expansion state and step
    instructions, focusing assertions on completion status and step text.
    Ensure test verifies that the "To run tests again..." message appears
    correctly in step text for system submissions, improving test coverage
    and reliability.
2025-10-16 test(course-page): add conditional rendering and enhance hints test
    Add explicit check for solution.hintsJson presence in template to satisfy
    TypeScript null safety. This prevents rendering null hints and improves
    type correctness.
    Enhance acceptance test for completing second stage to cover hints UI
    behavior: verify initial collapsed state, toggle hints expansion, and
    correct collapsing behavior when switching hints. Also verify step
    completion state updates when submission succeeds.
    These changes improve robustness and test coverage of the course stage UI.
2025-10-16 refactor(ui): simplify hint card handling and add fade transition
    Remove the HintCardList component and inline its functionality in the parent
    template to reduce complexity and improve clarity. Track the expanded hint
    index directly in ImplementSolutionStep to centralize state management.
    Add an ember-animated fade transition when showing and hiding the solution to
    enhance user experience with smooth visual feedback.
    Reset the expanded hint index when revealing or hiding the solution to ensure
    consistent UI state.
2025-10-16 fix(ui): center and adjust Hide Solution button styling
    Wrap the Hide Solution button in a flex container to center it properly
    within its parent. Remove unnecessary bottom margin and redundant
    background color to improve consistency in dark mode styles. This change
    enhances the layout and visual alignment of the button for better user
    experience.
2025-10-16 feat(course-stage-step): blur solution when hint is expanded
    Set solutionIsBlurred to true when a hint is expanded in the
    ImplementSolutionStep component. This improves focus on the hint
    content by blurring the solution, enhancing user experience during
    task completion.
2025-10-16 test(acceptance): wait for animations to settle after clicks
    Add calls to animationsSettled() after toggling solution reveal and hide
    buttons to ensure animation completion before asserting UI state. This
    improves test reliability by preventing race conditions in visual checks.
2025-10-16 refactor(ui): wrap solution button in AnimatedContainer
    Wrap the "Hide Solution" button inside an AnimatedContainer component
    to improve animation handling and consistency. This change ensures smoother
    transitions and better encapsulation of animation logic within the course
    stage step UI.
2025-10-16 refactor: move hide solution button outside content slot
    Relocate the "Hide Solution" button from inside the main content block
    to below the BlurredOverlay component. This improves layout structure
    and avoids unnecessary re-rendering of the content when toggling the
    button's visibility. The change also removes the extra bottom margin
    from the overlay container to maintain consistent spacing.
2025-10-16 fix(ui): update solution reveal button text for clarity
    Change the button label from "Click to reveal solution" to
    "Reveal complete solution" to provide clearer and more concise
    instructions to users on the course page.
2025-10-16 feat(course-page): improve language proficiency selection flow
    Add onSelect callback to SelectLanguageProficiencyLevelSection to notify
    parent component when a proficiency level is chosen. Remove intermediate and
    advanced level feedback messages to simplify guidance. Show a "Next question"
    button conditionally after feedback alert, enabling users to proceed only when
    appropriate. This enhances user interaction and navigation through the
    repository setup steps.
2025-10-19 fix(course-overview): conditionally display free course notice based on user access
    Update the course overview page to only show the free course notice if the current user does not have access to membership benefits. This change enhances the user experience by ensuring relevant information is displayed based on user permissions.
2025-10-20 feat(course): update track order to prioritize redis earlier
    Move 'redis' ahead of 'grep' in the course track sorting order to
    reflect updated learning priorities and improve user progression flow.
2025-10-21 feat(copyable-terminal-command): track analytics on copy action
    Add analytics event tracking when users copy terminal commands via the
    copy button. This change integrates the AnalyticsEventTrackerService to
    send details such as the copied text, copy method, and displayed commands.
    This improves insight into user interactions with terminal commands and
    enables better understanding of feature usage.
2025-10-21 feat(copyable-terminal-command): track copy events from text selection
    Add an action to handle copy events triggered by text selection in the
    terminal command component. The handler sends an analytics event with the
    copied text, copy method, and displayed commands to improve tracking of
    user interactions. This enables better understanding of how users copy
    commands from the interface.
2025-10-21 fix(copyable-terminal-command): improve copied text tracking
    Update handleCopyEvent to get copied text from the current
    document selection instead of clipboardData event. This change
    ensures accurate tracking of the copied terminal command text
    since clipboardData may not always be available during the copy event.
2025-10-21 feat(adapter): add x-browser-url header with current URL
    Include the current window location in the request headers as
    'x-browser-url' to provide the server with the client's URL context.
    This aids in better tracking and debugging of requests from the client side.
2025-10-22 refactor(ui): update first stage task instructions and code access
    Replace the file diff display with simplified instructional text to
    help users get started by uncommenting code. Adjust filename getter
    to access solution data directly for consistency and clarity.
2025-10-22 feat(course-page): improve task card layout for clarity
    Replace the bullet list with compact paragraphs in the first stage
    task card to simplify the instructions and enhance visual clarity.
    Use prose-compact styling to reduce space and improve readability.
2025-10-22 fix(ui): remove redundant instructional text from first stage card
    Eliminate the paragraph explaining how to pass the first stage by
    uncommenting code. The instructions were repetitive and cluttered the
    UI, so removing them improves clarity and user focus on task steps.
2025-10-22 fix(concept-list): ensure only published concepts are included in the list
    Update the concept filtering logic to include only concepts that are published. This change improves the accuracy of the concept list displayed to users.
2025-10-23 fix(course-page): simplify test results bar button logic
    Remove redundant condition checking for second course stage with
    failed tests. Staff users always see 'logs' and 'autofix' buttons,
    streamlining the UI logic and ensuring consistent button visibility.
2025-10-23 test: skip autofix acceptance tests no longer exposed
    Skip acceptance tests for autofix feature since it is no longer
    exposed as a user-facing feature. This prevents test failures
    and reflects the current state of the application while keeping
    the test code for potential future re-enablement.
2025-10-23 feat(course-overview): add detailed free course notice component
    Replace the simple free until date alert with a new FreeCourseNotice
    component that shows a richer UI. It displays whether the course is free
    this month or until a specific date, improving user clarity.
    Remove deprecated formatted date getter and consolidate date logic in
    the new component. Add support for `size` prop in Alert component to
    enable large alert styling used by FreeCourseNotice.
    These changes enhance the visibility of free course access periods and
    encourage membership sign-ups by promoting advanced features.
2025-10-23 feat(course-overview): improve free course notices and links
    Enhance the free course notice to support expiry dates both this
    month and specific future dates, updating test coverage accordingly.
    Fix free-course-notice component by adding a period after the date,
    correcting route names for "start free challenge" button and linking
    to the membership plans page using Ember's LinkTo component for
    better routing and accessibility.
    Update TimeService to skip timer setup during tests, preventing
    unnecessary timers and improving test reliability.
2025-10-23 feat(course): add isFreeThisMonth computed property and label update
    Introduce `isFreeThisMonth` to CourseModel to determine if a course
    is free at the end of the current month. Use TimeService for current
    time calculations instead of DateService. Update FreeCourseLabel and
    free course notices to reflect "FREE THIS MONTH" based on this new
    property, ensuring consistent and accurate messaging for users.
2025-10-23 test: simplify date handling in acceptance tests
    Remove explicit registration and setup of FakeDateService in view-courses
    test, replacing it with direct calculation of future dates. This reduces test
    complexity and dependency on a custom service.
    Also, update date instantiation in view-course-overview test to use an ISO string
    with explicit timezone, ensuring consistent time interpretation across environments.
    test(tests): standardize date handling and update free course notices
    Use consistent UTC timestamps when setting current time and freeUntil
    dates in acceptance tests to avoid timezone-related discrepancies.
    Adjust assertions in view-course-overview-test to match updated free
    cour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
2025-10-23 test: fix date times in course stages test for timezone consistency
    Update test dates to use noon UTC instead of midnight to ensure that
    expectations remain consistent across PST and UTC timezones. This change
    prevents potential test failures related to timezone differences and improves
    the reliability of acceptance tests for course page stages.
2025-10-23 feat(free-course-notice): improve responsiveness and layout
    Hide sparkles icon on small screens to reduce clutter and improve focus.
    Update button container to wrap and stack buttons vertically on small screens
    while keeping horizontal layout on larger screens. Add full-width styling to
    button on small devices for better usability and alignment.
2025-10-23 feat(course-overview): add notice for paid membership courses
    Add a new PaidCourseNotice component to inform users when a course
    is only accessible with a membership. Show this notice on the course
    overview page if the course is not free and the current user lacks
    membership benefits. This improves clarity about access restrictions
    and encourages users to consider membership plans.
2025-10-23 fix(ui): improve responsiveness of paid course notice buttons
    Add responsive styles to the paid course notice component to enhance
    usability on small screens. Hide the lock icon on smaller devices and
    adjust buttons to be full-width and stacked vertically on mobile,
    switching to inline layout on larger screens. This improves layout
    clarity and touch targets for mobile users.
2025-10-23 feat(course-card): convert to Glimmer component and unify course access
    Refactor CourseCard to a Glimmer component with typed args and computed
    properties for course, currentUser, and lastUsedRepository.
    Update template to consistently access course and user data via the
    component instance (`this.course`), improving readability and binding
    accuracy.
    Implement fallback logic for last used repository, prioritizing last
    pushed then last created repository for the current user.
    Remove comment lines suppressing Glint errors in catalog-loading to
    clean up the template.
    These changes improve type safety, maintainability, and correctness
    of course data rendering and user-specific repository stat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
2025-10-24 test: update user sign-in to subscriber and add lock icon tests
    Change sign-in method in acceptance tests from generic signIn to
    signInAsSubscriber to better reflect user role and access level in
    course progress and sorting tests.
    Add hasLockIcon property and corresponding test to course-card
    component to verify lock icon visibility on course cards.
    Enhance catalog-page test assertions to confirm correct lock icon
    presence based on course type (beta, free, live) for accurate UI
    feedback.
    Improve type safety and code clarity in catalog-page methods by adding
    explicit string parameters and replacing findBy with find logic for
    course and track selection.
2025-10-24 feat(modifier): add fire-confetti-on-insert modifier
    Introduce a new Ember modifier that triggers the confetti service
    to fire confetti from the inserted element. This change enables
    easy reuse of confetti effects on element insertion across the app,
    improving user feedback and celebration for interactive UI events.
2025-10-25 refactor(ui): replace upgrade prompt with paid course notice
    Replace the CourseStageStep upgrade prompt component with the
    PaidCourseNotice in the course stage instructions template to better
    reflect the user's course status.
    Remove the acceptance test suite for viewing the upgrade prompt as it
    is no longer relevant after the UI change.
2025-10-25 feat(file-tree-preview): add grayed-out state for tree items
    Add an isGrayedOut property to folder and file items to visually
    indicate disabled or inactive entries. Update styles to apply
    opacity and color changes when items are grayed out. Adjust folder
    children layout and connector lines to improve spacing and alignment
    for better visual clarity.
2025-10-25 fix(file-tree-preview): improve folder item lines and add placeholder file
    Update folder item template to render vertical connector lines alongside
    children, enhancing visual hierarchy of nested folders and files. Adjust
    spacing to maintain consistent alignment and include a small vertical line
    for the last child to improve clarity.
    Add a grayed out placeholder file ("README.md") under the "other files"
    folder to provide a more realistic example and improve UI completeness.
2025-10-25 feat(course): add workflow tutorial screens and repository typing
    Add new components for workflow tutorial steps and completion modal
    to improve user onboarding and guidance in the setup workflow.
    Update SetupStep to explicitly type the repository property for better
    type safety.
    Add a computed property pendingRepositoryWorkflowTutorialFeatureSuggestion
    on the user model to track relevant feature suggestions.
    Refactor course controller step type check to focus on CourseStageStep
    only, preparing for future UI enhancements like confetti on completion.
    Add a start-workflow-tutorial-screen template to display setup completion
    confirmation and next step actions.
2025-10-25 feat(setup-step-complete-modal): add back-to-review button and dismiss feature suggestion
    Rename back-to-review handler and prop to improve clarity in workflow tutorial
    completed screen. Add a new back-to-review button action that resets the tutorial
    to the first step. Update next button logic to dismiss the pending workflow tutorial
    feature suggestion when the tutorial completes, preventing repeated prompts.
    Add dismiss action to FeatureSuggestion model to encapsulate dismissal logic and
    persist the dismissal timestamp. Adjust templates and component calls to reflect
    the updated handler names and flows.
    These changes improve user navigation and ensure tutorial suggestions are properly
    dis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
2025-10-25 test: add workflow tutorial start course test and modal page object
    Introduce SetupStepCompleteModal page object for interacting with the
    setup completion modal. Add a new acceptance test verifying the start
    of a course with the workflow tutorial feature enabled.
    The test simulates user actions through repository setup, checks the
    modal visibility, and navigates through tutorial steps until reaching
    the first stage page. These changes ensure the workflow tutorial is
    properly integrated and functional within the course start process.
2025-10-25 feat(course-page): add "step previously completed" screen
    Add a new screen to the SetupStepCompleteModal for steps that have
    already been completed. This screen shows a completion message, a
    button to navigate back to the current stage or step, and a button
    to view instructions again.
    Rename the "Show instructions again" handler and related args from
    onShowInstructionsAgainButtonClick to onViewInstructionsButtonClick
    for clarity and consistency across components.
    These changes improve user experience by clearly indicating when a
    setup step was previously completed and providing easy access to
    revisit instructions or navigate the course.
2025-10-25 feat(course-page): enhance workflow tutorial visuals and file tree
    Replace static images with dynamic content in setup step modals for a
    more engaging user experience. Step 1 now displays a file tree preview
    based on the repository's first stage solution, improving clarity on
    editable files. Step 2 uses an animated background to better illustrate
    the git push workflow. These changes aid users in understanding the
    course setup process more effectively.
2025-10-25 feat(course-page): add step switcher to setup tutorial modal
    Introduce StepSwitcher component to display and switch between tutorial
    steps in the SetupStepCompleteModal. This allows users to navigate
    directly to a specific step in the workflow tutorial instead of only
    progressing linearly.
    Update WorkflowTutorialStep1Screen and Step2Screen layouts to include
    the step switcher beneath the Continue button for better navigation.
    Add handleStepSelect action in the modal to update currentScreen on step
    selection, supporting dynamic screen changes based on user input.
    Adjust modal padding and button margins for improved spacing and visual
    balance.
2025-10-26 feat(course-card): add Visit Course Overview button and improve layout
    Introduce a new VisitCourseOverviewButton component that links to the
    course overview page, providing users a clear call-to-action. Adjust the
    course card layout by increasing the intro section height from 60 to 80
    to accommodate more content, and reorganize elements for better visual
    hierarchy. Move the introduction markdown above the stages list and add
    the new button overlay at the bottom. Also update button styles to ensure
    consistent theming for signup and preview actions. These changes enhance
    usability and navigation within the course cards.
2025-10-26 refactor(course-card): remove unused language prop from VisitCourseOverviewButton
    Remove the language argument from VisitCourseOverviewButton as it is no longer
    used within the component. This simplifies the template and component interface,
    reducing unnecessary data passing and potential confusion.
2025-10-26 feat(course): add language context to course overview navigation
    Pass the selected language/track as a query parameter and component arg
    to enable language-specific course overview rendering. Update navigation
    from track cards to point to the course overview route with the language
    query param. Reset controller state when exiting the course route to clear
    stale data. These changes support multi-language track browsing and
    improve state handling on navigation.
2025-10-26 test(course-page): add start course interaction in acceptance tests
    Add clicks on the start course button to course page tests to ensure
    navigation from course overview to course introduction works correctly.
    Verify the URL updates as expected after starting the course to improve
    test coverage and stability around course navigation flows.
2025-10-27 feat(course-page): add admin link to repository dropdown
    Add an "Admin" button to the repository dropdown for staff and course
    authors, enabling quick navigation to course admin submissions. Remove
    the redundant admin button from header navigation controls to improve
    UI consistency and reduce clutter.
2025-10-27 test(acceptance): move admin button visibility check to dropdown
    Refactor course page tests to check for admin link visibility inside
    the repository dropdown instead of the standalone admin button. This
    change aligns the tests with the updated UI where admin actions are
    accessed via the dropdown menu. Ensures accurate validation of admin
    access visibility based on user roles and course authorship.
2025-10-28 feat(course): add support for Shell course and embed tutorial video
    Add a new boolean property `isShell` to the Course model to identify the
    Shell course. Display an embedded tutorial video on the first-stage task
    card page when the course is Shell. Improve layout by adding spacing
    between instruction text, video embed, and the tutorial heading for better
    visual hierarchy and readability.
2025-10-28 refactor(first-stage-your-task-card): improve video embed safety
    Inject the service import consistently and add a type import for CourseStageStep to
    improve code clarity. Replace raw triple-curly braces with `html-safe` in the template
    to securely render the embedded video HTML and prevent potential XSS vulnerabilities.
2025-10-29 fix(video-embed): hide title and controls on loom video iframe
    Add URL parameters to the Loom iframe embed to hide the title,
    top bar, and owner info for a cleaner, distraction-free video
    presentation. This improves the user experience by focusing
    attention on the content within the course stage.
2025-10-29 style: increase spacing in first-stage-your-task-card content
    Increase bottom margin of instructions div from mb-3 to mb-5 for better
    visual separation. Also increase bottom margin of video embed container
    from mb-5 to mb-8 to improve layout spacing when the video is displayed.
    These changes enhance readability and overall visual balance of the card.
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2025-10-29 Replace all `compact` usages with `filter`
2025-10-29 Replace all `filterBy` usages with `filter`
2025-10-29 Replace all `mapBy` usages with `map`
    [course-idea-card.gts]
2025-10-29 Replace all `reject` usages with `filter`
2025-10-29 Replace all `rejectBy` usages with `filter`
2025-10-30 refactor: remove step switcher component and references
    Remove the StepSwitcherContainer component and its logic from the codebase
    due to redesign or simplification of navigation controls. Also remove its use
    from the navigation controls template to clean up the UI and improve code maintainability.
2025-10-30 refactor(course-page): improve header layout and simplify controls
    Move the mobile sidebar toggle button to the main header section for better
    accessibility and visual hierarchy. Remove redundant mobile sidebar button from
    the top-right section and adjust flex layouts for cleaner alignment and spacing.
    Update padding in course template for consistent vertical spacing. Remove unused
    onMobileSidebarButtonClick arg from top-right section component. These changes
    enhance usability and streamline the header UI.
2025-10-30 test: remove unused FakeDateService import from acceptance test
    Clean up the view-course-stages-test by removing the unused import of
    FakeDateService. This reduces clutter and improves code maintainability
    without affecting test functionality.
2025-11-01 feat(setup-step-complete-modal): pre-cache workflow animation image
    Add a did-insert action in SetupStepCompleteModal to pre-fetch the
    workflow animation GIF and reduce flickering on load.
    Update the background image URL in workflow-tutorial-step2-screen to
    use the pre-cached GIF version.
    Add passthrough for codecrafters.io image URLs to the Mirage config.
    These changes improve the user experience by ensuring the workflow
    animation loads smoothly without visible delays.
2025-11-01 feat(course-admin): add type annotations and improve model typing
    Add explicit TypeScript types for the submissions route model and service
    injections to enhance type safety and code clarity. Update the model method
    to use typed parameters and cast return values for submissions and languages.
    Add route model type declaration to the controller to align with route output.
    These changes reduce type errors and improve maintainability for course admin
    submissions filtering and querying logic.
2025-11-01 feat(course-admin): enhance submissions page and tabs usability
    Refactor submissions page component to improve type safety by adding
    explicit TypeScript typings and interfaces. Initialize tracked properties
    more defensively to avoid null issues. Replace deprecated Ember service
    injection syntax with modern declaration style.
    Add new action handler for submission selection to better manage UI state.
    Update template to use this action instead of mut helper for clearer data
    flow.
    Extend tabs component and submissions page submission details with an
    isGrayedOut flag to indicate disabled tabs based on submission state,
    improving UX clarity.
    Overall, these changes improve code maintainability,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
2025-11-01 fix(ui): suppress Glint error for nullable language prop
    Add a Glint expect error comment to the FileDiffCard component usage
    to handle the case where the language property can be null. This prevents
    type checking errors and ensures smoother integration with the type system.
2025-11-08 Fix light mode flickering when switching between dark-mode-supporting routes
2025-11-12 feat(autofix-container): add autofix request creation and error handling
    Implement a task to create autofix requests for submissions and handle
    errors when the creation fails. Introduce a button in the template to
    trigger this task with a loading state spinner and show a user-friendly
    error message if saving the request fails. This enables admins to
    initiate autofix requests directly from the submission details page.
2025-11-13 fix(submissions-page): improve autofix request button and error display
    Update the autofix request button to conditionally show "Retry Autofix
    Request" when there are existing requests, otherwise display "Create
    Autofix Request". Fix template syntax by properly closing the conditional
    block. Move the error alert outside the button to ensure correct UI
    rendering. These changes enhance user clarity and improve component
    structure.
2025-11-13 feat: show only the latest autofix request on submission details
    Refactor submission details to display only the most recent autofix
    request instead of all requests. This improves clarity by highlighting
    the latest autofix status. Update button logic to reflect whether a
    latest autofix request exists, changing label from create to retry
    accordingly. Add a computed getter to retrieve the latest autofix
    request sorted by creation date.
2025-11-13 feat(test-results-bar): enable resizable expanded container height
    Add support for dynamically resizing the expanded test results bar height
    via mouse and touch events. Track bottom section element height to
    calculate available space correctly. Introduce isResizing state to
    manage height transition during resizing and update style handling
    accordingly for smooth UX.
    This improves usability by allowing users to adjust the test results bar
    height to their preference instead of a fixed height.
2025-11-14 test: improve resize test for test results bar with better timing
    Refactor the course-page test-results-bar resize tests to add explicit
    waits for CSS animations, ensuring stable assertions after UI changes.
    Remove redundant service registration for FakeActionCableConsumer to
    simplify setup. Adjust mouse and touch move events with a +1px offset
    to account for border or layout inconsistencies.
    Verify right mouse button does not resize and left mouse button does,
    and confirm height persistence after collapsing and expanding the bar.
2025-11-15 feat: add fade transition to completion modals
    Wrap completion notices in AnimatedContainer with animated-if to
    apply a 200ms fade transition on modal dismissal for smoother UI
    feedback. Define and consistently use the fade transition in both
    CurrentStepCompleteOverlay and TestsPassedOverlay components to
    improve visual polish when showing or hiding completion modals.
2025-11-15 feat(course-page): add notice and overlay for incomplete steps
    Introduce PreviousStepsIncompleteNotice component to inform users
    when prior steps are incomplete, preventing access to the current
    stage. Add a back button linking to the active step for easier
    navigation.
    Enhance PreviousStepsIncompleteOverlay with animated display of the
    notice and implement fade transitions. Track modal dismissal state to
    reset visibility when steps unlock, ensuring users are properly
    notified throughout navigation.
2025-11-15 fix(course-page): update overlay logic to track step status
    Change overlay to track current step status instead of step id.
    This ensures the modal visibility updates correctly when step status
    changes, especially unlocking steps after dismissal. Simplify logic
    to reset dismissal state whenever the step status changes.
2025-11-15 fix(animation): shorten modal dismissal animation duration
    Reduce the animation duration from 200ms to 150ms in the current
    step complete, previous steps incomplete, and tests passed overlays
    to create a snappier and more responsive user experience when
    dismissing modals.
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2025-11-17 feat: add isArchived flag to filter out archived course ideas
    Add a new boolean attribute `isArchived` to CourseExtensionIdea model to
    mark ideas that should be excluded from active views. Update multiple
    components and controllers to filter out archived ideas, ensuring only
    relevant and current extension ideas appear in course listings, roadmap,
    and latest releases. This improves clarity and user experience by hiding
    outdated or deprecated content without deleting data.
2025-11-18 feat(instructions): restrict test results UI updates to staff users
    Refactor test results bar behavior in course stage instructions to
    only toggle expansion and collapse for staff users. Non-staff users
    still trigger scrolling to the top when tests pass. This change adds
    a user role check to control UI updates and prepares for a future
    feature flag implementation.
2025-11-18 refactor: always show leaderboard link and simplify feature flag usage
    Remove conditional check on leaderboard feature flag when adding the
    Leaderboard link in the header to display it for all users. Eliminate
    the shouldSeeLeaderboard getter from the feature flags service as it
    is no longer used. Also simplify the course page modal by removing
    the redundant computed property that checked the leaderboard feature
    flag, instead relying directly on current step type checks in the
    template. These changes improve code clarity and ensure the leaderboard
    is consistently accessible.
2025-11-18 feat(test-results-bar): separate mouse and touch resize handlers
    Refactor resize start actions by splitting startResize into
    startMouseResize and startTouchResize to clearly separate mouse
    and touch event handling. This prevents unnecessary checks
    within a single method and improves event management.
    Add event listeners for mousemove and mouseup only on left
    mouse button clicks in startMouseResize. Maintain touch event
    handling in startTouchResize.
    Update template bindings to use the new actions.
    Fix flaky touch resize acceptance test by awaiting settled()
    after touchEnd to ensure stable test results.
2025-11-19 refactor(test-results-bar): simplify collapse button handling
    Remove the onCollapseButtonClick arg from TopSection and move the collapse
    button out of TopSection into the main component template. This consolidates
    the collapse button logic and prepares for future UI refinements related to
    log section resizing.
2025-11-19 fix(course-page): handle null autofixRequests safely
    Ensure lastSubmission.autofixRequests defaults to an empty array when null.
    This prevents runtime errors during filtering non-staff autofix requests and
    improves the stability of the test-results-bar component.
2025-11-19 fix(ui): allow vertical scrolling in autofix request card
    Change the overflow style from hidden to auto on the y-axis in the
    autofix-request-card component to enable vertical scrolling when content
    exceeds the component height. This improves usability by preventing content
    from being clipped.
2025-11-23 style: improve dark mode text contrast in headers
    Update header text color from dark:text-gray-50 to dark:text-gray-100
    in several components to enhance readability and visual consistency
    in dark mode. This change affects the track page header, code examples
    section, and course overview page header.
2025-11-23 style: enhance header text styles with gradient and spacing fixes
    Update track-page and course-overview-page headers to apply a text
    gradient that adapts to light and dark modes, improving visual appeal.
    Adjust vertical margins for better spacing consistency across screen
    sizes. Add right padding to the track-page header title to prevent the
    background gradient from cutting off the trailing period. These changes
    improve readability and aesthetics of the page headers.
2025-11-23 fix: update dark mode button colors for better contrast
    Adjust primary-button and primary-link-button to use darker teal shades
    in dark mode for improved accessibility and visual consistency.
    Change text color to teal-50 in dark mode to enhance readability.
2025-11-23 style: update dark mode background and text colors to gray-925
    Change multiple components and templates to use a darker shade of gray
    (dark:bg-gray-925 and text-gray-925) instead of the previous
    dark.gray-900. This improves visual consistency and contrast in dark
    mode across the app, including course pages, sidebars, profile
    textareas, feedback forms, and the
    application container.
    [vote-button.gts]
2025-11-23 fix: update dark mode backgrounds for better contrast
    Change multiple components to use darker backgrounds in dark mode,
    replacing gray-850 with gray-900. This improves visual consistency
    and contrast across modals, buttons, cards, and other UI elements,
    enhancing readability and user experience in dark theme.
    [course-idea-card.gts]
2025-11-23 feat(tailwind): add OKLCH color mixing and use for gray shades
    Introduce a mixOklch function to blend two OKLCH colors by a given
    ratio, ensuring smooth interpolation of lightness, chroma, and hue with
    proper clamping and shortest hue angle interpolation.
    Replace hardcoded gray color hex values with dynamically mixed colors,
    improving color consistency and flexibility in the design system.
2025-11-23 style: update gray-925 color references to gray-950 for better contrast
    Replace all instances of the gray-925 color with gray-950 across
    multiple components to improve visual contrast and consistency in dark
    mode styling. This change affects various UI elements including the
    footer, headers, buttons, badges, and overlays to enhance readability
    and maintain a cohesive
    design system.
    [vote-button.gts]
2025-11-23 style: update gray color shades to improve contrast and consistency
    Adjust multiple components to use darker and more consistent gray
    shades (gray-900 and gray-925) instead of lighter variants
    (gray-850 and gray-700). This enhances visual contrast and aligns
    with the design system updates across alerts, buttons, modals,
    course pills, question cards, and file content cards.
    [course-idea-card.gts]
2025-11-23 refactor(billing-status-badge): update badges to use buttons with icons
    Change VipBadge element from div to button for better semantics and
    interaction. Add buttonSize getter to map size args to PrimaryButton
    sizes. Replace VIP and Member badges' container div/span with flex
    containers that include shield-check icons and consistent spacing. This
    improves accessibility, styling,
    and consistency across badges by using PrimaryButton and
    PrimaryLinkButton components.
2025-11-23 style(pricing): improve dark mode styling and button appearance
    Update dark mode background and border colors in the pricing plan card
    to enhance contrast and visual consistency. Adjust text color shades for
    better readability on dark backgrounds. Refine the recommended plan
    button styles with improved border, background, and hover effects for
    both light and dark themes. These changes improve the overall UI clarity
    and user
    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
2025-11-24 feat: add dark mode styles to key components
    Update copyable-code, concept-page, and question-card components
    to support dark mode by adding appropriate dark: classes. This
    improves readability and visual consistency for users using dark
    themes. Adjust buttons, borders, backgrounds, and text colors to
    ensure accessibility and maintain design integrity across modes.
2025-11-24 feat: add dark mode styles and improve join route support
    - Update testimonial-list-item and logo-cloud components to support dark
    mode with appropriate background, text, border, and image filters.
    - Adjust join route metadata to enable both light and dark color
    schemes. - Remove TODO comment and add dark mode background to join
    template. - Enhance join page heading with gradient text supporting dark
    mode. - Clean up router by removing join dark mode TODO comment.
    - These changes improve visual consistency and usability in dark mode
    - d
    enable dark mode support on the join page.
2025-11-24 feat(concepts): add dark mode styles and update route color scheme
    Update concepts route to support both light and dark color schemes.
    Enhance concepts template with dark mode styles for background, borders,
    and text to improve readability in dark environments. Adjust button icon
    color in dark mode for better visibility. These changes improve UI
    consistency and accessibility for users preferring dark mode.
2025-11-24 style: improve dark mode styles in paid course notice
    Enhance the paid course notice component to better support dark mode.
    Add dark mode text and border colors for headings, icons, and links to
    improve readability and visual consistency. Update hover states and
    button borders to ensure accessibility and maintain the design
    language across light and dark themes.
2025-11-24 new [percy]
    Extract the team dropdown item UI into a dedicated Glimmer component to
    improve code modularity and readability. Replace inline markup with the
    new CourseLeaderboardTeamDropdown::Item component for each team and the
    "Everyone" option, passing props for text, logo, and active state. This
    centralizes styling and behavior, making the dropdown easier to maintain
    and extend.
2025-11-24 fix(ui): remove redundant text color from language button
    Remove the explicit gray text color on the "Show Other Languages" button
    to allow the hover state color to take effect consistently. This
    improves visual clarity and maintains color consistency on hover for
    better user
    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
2025-11-24 feat: add analytics tracking for reveal actions in autofix card
    Replace inline state mutation on button clicks with dedicated
    action handlers in AutofixRequestCard component. Add tracking of
    analytics events when users reveal the fixed code or explanation
    sections, providing insight into user interactions with autofix
    requests.
2025-11-24 refactor: remove AutofixResult component and related template
    Remove the AutofixResult component and its corresponding template
    to simplify the test-results-bar autofix section. This eliminates
    logstream handling, status indicators, and feedback buttons related
    to autofix results, reducing complexity and improving maintainability.
2025-11-25 test: call onConnect callback when subscribing
    Invoke the onConnect callback immediately upon adding a new
    subscription in fake-action-cable-consumer. This ensures that any
    setup logic depending on connection confirmation runs promptly
    during tests, improving test accuracy and behavior simulation.
2025-11-25 feat(autofix-request-card): improve UI for in-progress and success states
    Replace placeholder hint content with a dedicated LogstreamSection
    component for in-progress autofix requests to provide real-time logs.
    For completed requests, restructure blurred overlays to separate
    explanation and diff renders, ensuring clearer user focus.
    Add conditional buttons to reveal either the fixed code or more
    explanation based on request status, enhancing user control and insight
    into autofix
    results. This refactor improves UX clarity and maintains code
    readability.
2025-11-26 fix(logstream-section): improve toolCall ID generation and animation
    Use dynamic IDs for fake analysis tool calls instead of a fixed ID to
    avoid potential conflicts. Insert completed analysis action correctly
    based on last analysis action index. Reduce animation duration from
    300ms to 100ms
    for smoother and faster UI updates in LogstreamSection component.
2025-11-26 feat(feature-flags): add autofix flow visibility flag
    Add a new feature flag `canViewAutofixFlow` to control access to the
    autofix flow based on the 'autofix_flow' flag or staff user status.
    Update course-page and course stage instructions components to use this
    flag for conditionally displaying the autofix tab and enabling related
    behaviors, replacing previous staff-only checks. This allows gradual
    rollout of autofix features via feature flags.
2025-11-27 feat: add 'internal' creatorType to autofix requests
    Extend AutofixRequest model to include a new creatorType 'internal'
    alongside 'staff'. Update the creatorTypeIsStaff getter to also check
    for 'internal' creators. Modify filtering logic in test-results-bar to
    exclude autofix requests from both staff and internal creators when
    determining the last applicable request. This change clarifies and
    improves the classification of autofix request creators for more
    accurate handling in the UI.
2025-11-27 style: reduce top margin of Explain more button to mt-6
    Decrease the top margin of the Explain more button in the autofix
    request card component from mt-10 to mt-6 to improve visual spacing
    and alignment. This change enhances the UI consistency and overall
    appearance on the course page test results bar.
2025-11-27 refactor(ui): restructure autofix explanation and diff display
    Wrap explanation and file diffs in a single parent div to improve layout
    and clarity. Adjust button texts and their handlers to better reflect
    their actions ("Explain more?" for explanation, "Show fixed code" for
    diffs). This enhances user understanding and interaction with autofix
    request
    details.
2025-11-27 fix(ui): restructure autofix request card for clarity
    Replace nested animated-if with simpler if condition to address
    animation issues. Rearrange explanation and fixed code overlays into
    distinct blocks to improve readability and user interaction. Adjust
    button labels and spacing for consistency. These changes simplify the
    template logic and fix
    visual inconsistencies in the AutofixRequestCard component.
2025-11-27 fix(autofix-request-card): simplify animated-if usage and reorder overlays
    Replace animated-if with plain if for in_progress status to avoid issues
    with animation behavior. Reorganize BlurredOverlay sections for better
    clarity: show explanation markdown with overlay first, then animate the
    display of changed files with their overlay. Update button labels and
    spacing to improve user experience when showing explanations and fixed
    code. These changes fix UI glitches and enhance code readability.
2025-11-27 feat(autofix-request-card): add toggle button to show/hide fixed code
    Replace blurred overlay with a toggle button that switches between
    showing and hiding the fixed code diff. This improves UX by giving users
    direct control over visibility instead of relying on overlay click
    areas. Track reveal and hide events to record user interaction with the
    diff
    visibility. Update component state accordingly to reflect current view.
2025-11-27 fix(ui): add small size to SecondaryButton in autofix card
    Update SecondaryButton components in the autofix-request-card to use
    the small size variant. This change improves the visual balance and
    consistency of the buttons within the overlay, enhancing the overall
    user interface and experience.
2025-11-27 fix: remove commented out analytics tracking for hidden autofix diff
    Remove the commented out call to track 'hidden_autofix_diff' event
    when the autofix diff is hidden. This cleans up the code by eliminating
    dead code that is not currently used or needed.
2025-12-01 feat: add verifications to community course stage solutions
    Introduce CommunitySolutionVerificationModel to track solution
    verification statuses. Extend CommunityCourseStageSolutionModel to
    include verifications relation and load verifications by default.
    Update course-admin code example insights route to include the new
    defaultIncludedResources and improve language selection logic for
    better accuracy when filtering solutions.
2025-12-01 feat(mirage): add verifications relationship to community solution
    Add a hasMany relationship for 'community-solution-verification' to the
    community course stage solution model. This enables tracking of verifications
    associated with each community solution, improving data integrity and support
    for verification features.
2025-12-02 feat(gifts): improve redeem button layout for anonymous users
    Wrap the redeem button content in a flex container to better align the
    GitHub icon and text when the user is anonymous. Adjust the icon size
    to fit the new layout. This enhances the button's visual clarity and
    user experience during the redeem process.
2025-12-02 feat(gifts): revamp redeem page UI and update styles
    Add CodeCrafters logo and improve layout on the redeem gift page to
    enhance branding and user experience. Change route metadata to use
    dark color scheme only for better visual consistency.
    Include new cursive fonts (Indie Flower and Shadows Into Light Two)
    via Google Fonts in index and test HTML to support updated styling,
    and set a default cursive font CSS variable.
    Refactor template with gradients, typography, and spacing to create a
    more polished and engaging gift redemption interface.
2025-12-02 feat(redeem): enhance gift redemption page with new layout and content
    Redesign the Redeem Gift Card page to improve user experience and engagement.
    - Add a distinct background and larger container with responsive padding.
    - Update title styling for better visibility and responsiveness.
    - Display sender's gift message with improved typography and layout.
    - Enhance redeem button with dynamic states, tooltips for user context, and
    better accessibility for anonymous and member users.
    - Add reassuring note "No credit card required" below the redeem button.
    - Introduce new sections including a trusted companies headline with description,
    a logo cloud of affiliate companies, and a Build Your O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
2025-12-02 test: improve redeem gift page tests and update UI elements
    Refactor redeem gift page test selectors to simplify access by moving
    redeemButton out of giftDetailsContainer. Add a new giftMessageContainer
    to target the gift message with clearer scope. Update template to include
    data-test attribute on the gift message container for reliable selection.
    Enhance test assertions to check for the full gift message including
    sender signature, improving test accuracy and coverage. Adjust CSS class
    usage in tests to better reflect UI state. These changes improve test
    robustness and maintainability while aligning tests with current UI.
2025-12-02 feat(track-card): enhance hover animations for smoother transitions
    Update track-card styles to add easing and duration to hover effects,
    improving user experience with smoother and more noticeable animations.
    Add transition easing and duration to logo scaling, action text opacity
    and position, and arrow icon color and movement. Adjust margins and
    translate values for better visual alignment on hover.
2025-12-03 test: add gift redemption test and update redeem flow
    Add a new acceptance test to verify the full gift redemption flow,
    including creating a gift, redeeming it, and confirming membership
    activation on the billing page.
    Enhance the redeem controller by awaiting authenticator sync after
    redeeming to ensure immediate membership availability and redirect
    to the billing page instead of the catalog.
    Update Mirage handlers to support redeeming membership gifts by
    marking gifts as redeemed and creating corresponding subscription
    records with appropriate start and cancel dates.
    These changes improve test coverage for the redeem feature, fix user
    experience by accurate redirection, and enhance ba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
2025-12-03 feat(gift-card): improve animation timing and responsive styling
    Extend rotate-in animation duration to 1.5s and apply a custom
    "bouyant" timing function for smoother, more dynamic motion. Remove
    scale transform to simplify rotation effect.
    Enhance gift message container responsiveness by adding a larger
    max-width on small screens and increase font size for better
    readability on wider devices.
2025-12-03 feat(gift-payment): move save logic out of step containers
    Refactor EnterDetailsStepContainer and ChoosePlanStepContainer to remove
    embedded saving tasks. Instead, delegate save handling to the parent
    controller via a new onGiftPaymentFlowUpdate callback. This simplifies
    step containers and centralizes gift payment flow saving in GiftsBuyController.
    Modify GiftsBuyController to include saveGiftPaymentFlowTask and
    handleGiftPaymentFlowUpdate action, which performs saving when invoked.
    Update gift-payment template to pass onGiftPaymentFlowUpdate callback to
    step containers. These changes improve separation of concerns and make
    the saving process more explicit and manageable.
2025-12-03 feat(welcome): add route color scheme metadata
    Add buildRouteInfoMetadata method to welcome route to specify a
    color scheme for consistent theming.
    style(onboarding-survey): improve dark mode appearance
    Update selectable-item and onboarding survey wizard components with
    dark mode styles, including button borders, text, backgrounds, and
    icons to enhance usability and visual consistency in dark mode.
2025-12-03 fix(base-button): add active state styles when enabled
    Add active state styles including a slight scale transform and
    transition effects for better visual feedback on button press.
    Remove these styles when the button is disabled to prevent
    interaction cues. This improves user experience by clearly
    indicating button interactivity.
2025-12-03 style(base-button): improve padding and active state styles
    Update padding sizes for base-link-button to better align with design
    standards and ensure consistent font weight handling. Adjust disabled
    opacity and active scale transform effects on both base-link-button and
    base-button for smoother interaction feedback and improved accessibility.
2025-12-03 refactor(onboarding-survey-wizard): improve step animation handling
    Replace animated-if with animated-value to control animation state in the
    OnboardingSurveyWizard component. This change enables smoother step
    transitions by explicitly tracking the currentStep animation value,
    improving rendering consistency during step changes in the onboarding
    survey flow.
2025-12-03 feat(pay): add regional discount fetching and display
    Fetch the current regional discount record on pay page container insertion
    and track it in the controller. Update the template to show the regional
    discount notice using the tracked discount data instead of relying on the
    model's property. This enables dynamic fetching and display of regional
    discounts without requiring a full route model refresh.
2025-12-04 feat(gifts): add gift management route and page
    Add a new route 'gifts.manage' to enable users to manage gifts
    via a management token. Update success URL in payment flow to
    redirect to the new management page. Implement route, controller,
    and template for gift management with dark mode support and
    anonymous access handling. Redirect to 'not-found' if token is
    invalid.
2025-12-04 feat(gifts): add edit button to sender message section
    Add a small tertiary button with a pencil icon labeled "Edit" below
    the sender message in the gifts management template. This allows users
    to easily initiate editing of the sender message, improving usability
    and enhancing the user interface for managing gifts.
2025-12-04 feat(gifts): add inline editing for sender message with save/cancel
    Enable editing of the sender message directly in the UI by making the
    message text contenteditable when in edit mode. Add Save and Cancel buttons
    to confirm or discard changes. Implement an Ember Concurrency task to handle
    async saving of updated messages with loading state and disable buttons
    during save. Adapt URL construction to include management_token for updates.
2025-12-04 feat(gifts): focus message and place cursor at end on edit
    Improve UX in gift editing by automatically focusing the message
    element and placing the cursor at the end when entering edit mode.
    Use Ember's runloop next() to ensure contenteditable is set before
    manipulating the cursor. This enhances text editing flow and user
    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
2025-12-05 test(gifts-manage-page): add page object properties for gift message
    Add clickable actions for edit, save, and cancel buttons on the gift
    management page. Add a text property to access the editable gift message
    text. These changes improve test interaction capabilities with the gift
    message UI elements.
2025-12-05 test: add ability to create gift message when none exists
    Enhance gift message management by allowing users to add a new message
    if none exists. Update the manage gift page template to display an
    "Add gift message" button when the sender message is absent. Improve
    controller logic to handle empty initial messages and trim whitespace
    on save. Add acceptance test coverage for adding a gift message, in
    addition to editing existing messages. These changes improve UX by
    supporting message creation from scratch and ensure data is persisted
    correctly.
2025-12-05 test(acceptance): support multi-line messages in gift editing
    Update gift message handling to allow multi-line text input and
    rendering in the manage gift page acceptance tests. Adjust the sample
    sender messages and assertions to include line breaks, ensuring that
    message editing and persistence support formatting with multiple lines.
    This improves the realism and coverage of message editing scenarios.
2025-12-05 feat(copyable-code): add fade animation for copy button state
    Enhance the copy button by animating the label change between "COPY"
    and "COPIED" using ember-animated's fade transition. This improves
    user feedback clarity by visually emphasizing the copy action state.
2025-12-05 feat(gifts): add redeemUrl getter and update share UI
    Add a redeemUrl computed property to MembershipGiftModel that returns
    a fully qualified URL for redeeming the gift using the secret token.
    Update the gifts manage template to display the dynamic redeem URL in
    the CopyableCode component for sharing with recipients.
    Enhance the copy button handler to write the redeem URL directly to the
    clipboard. These changes improve user experience by providing a clear,
    correct link for gift redemption and simplifying copying it.
2025-12-05 feat(membership-gift): require management_token for updates
    Refactor MembershipGiftAdapter to get management_token from adapterOptions
    instead of router service, enforcing explicit token passing when updating a
    membership gift. Throw an error if the token is missing to prevent silent
    failures.
    Update GiftsManageController to pass management_token from current route
    params via adapterOptions when saving the gift model. This ensures the token
    is consistently provided and decouples adapter from router service.
2025-12-05 feat(gift-message): add animated transitions for edit buttons
    Add fade animation when toggling between edit and save/cancel buttons
    in the gift message component to improve UI feedback. Move the GiftMessage
    component to the top of the gift management page for better visibility.
    Also, defer resetting isEditing until after updating the message to avoid
    UI inconsistencies during async updates. Update the add gift message button
    layout to include an icon for clearer affordance.
2025-12-08 feat(gifts): prefill sender email on gift payment creation
    Inject the authenticator service to access the current user and
    prefill the senderEmailAddress on new gift payment flow records.
    This improves user experience by auto-populating sender details
    when creating a gift purchase, reducing manual input.
2025-12-08 feat(gifts): add "Buy another gift" button to manage page
    Reduce bottom margin of gift container for better spacing and add a
    PrimaryLinkButton on the manage gift page that links to the gift purchase
    route and opens in a new tab. Refactor PrimaryLinkButton to accept and
    pass the shouldOpenInNewTab argument to support this new behavior. These
    changes improve user flow by making it easier to purchase additional gifts.
2025-12-10 feat(prerender): add config and function for gifts buy page
    Add prerender configuration with 24-hour expiration and enable
    passing query parameters for the gifts buy page. Include the
    shared Ember route prerender function to handle rendering logic.
    These changes improve caching and dynamic rendering support for
    the gifts purchase flow.
2025-12-10 feat(gifts): add error handling UI for gift redemption failures
    Track redeemError state to display an error message when gift
    redemption fails. Clear redeemError before redemption attempts
    and show a user-friendly alert on failure instead of throwing
    errors. Improves user experience by providing clear feedback
    during the redemption process.
2025-12-10 fix(redeem): capture errors during gift redemption with Sentry
    Add Sentry error reporting in the gift redemption flow to track and
    monitor exceptions that occur during the process. This improves error
    visibility and aids in quicker diagnosis of issues affecting users.
2025-12-10 feat(redeem): show redeemed state and improve UX on gift card page
    Display a checkmark animation and a message when a gift card is already
    redeemed, providing contact info for support. Update redeem button with
    contextual tooltips based on user status and clearly indicate when
    redeeming is in progress. Add confirmation text that no credit card is
    required and surface any redeem errors prominently. These changes improve
    clarity and feedback during the gift redemption process.
2025-12-10 refactor(redeem): remove redeemed message and animation
    Remove the conditional display of the redeemed gift message and the
    checkmark animation from the redeem gift card template. Simplify the
    UI by always showing the redeem gift card header. This change clarifies
    the redemption flow and avoids displaying outdated redemption status.
2025-12-10 test(acceptance): add redirect test for redeemed gifts
    Add a test to verify that visiting the gift management page
    with a redeemed gift redirects to the redeemed page. This
    ensures correct user flow and prevents managing already
    redeemed gifts.
2025-12-10 docs: update development workflow testing instructions
    Clarify test running procedure in development workflow
    documentation by specifying the exact URL format to use when
    running tests in the browser. Emphasize the requirement to use
    the filter query parameter to limit test execution, preventing
    running all tests and saving developer time.
2025-12-10 feat(gifts): ensure primaryEmailAddress is loaded for user
    Add logic to authenticate the user if already authenticated to guarantee
    that primaryEmailAddress is available before creating a new gift-payment-flow
    record. This change prevents issues where the sender email might be missing
    due to incomplete user data loading in the buy gift flow.
2025-12-16 feat(pay): add action to close membership plan modal
    Introduce handleChooseMembershipPlanModalClose to reset plans
    query parameter and close the membership plan modal. This change
    improves navigation flow by allowing users to exit the modal cleanly.
2025-12-16 fix(pay-page): redirect to pay page with query param on login
    Update the login redirect URL to include ?plans=true query parameter
    when the user is not authenticated and clicks the continue button. This
    ensures the plans view is shown after login, improving the user flow on
    the membership plan selection modal.
2025-12-16 feat(gifts): scroll to top on buy route activation
    Add scrollToTop utility call in the buy route's activate hook to ensure
    the page resets scroll position when entering the gift purchase flow.
    Update the pay template to change the referral link to direct users to
    the gift purchase route with updated text, improving user navigation and
    clarity around gifting options.
2025-12-16 feat(components): add SecondaryLinkButton component for styled links
    Create SecondaryLinkButton as a wrapper around BaseLinkButton with
    teal border and text styles for secondary actions. It accepts the same
    arguments as BaseLinkButton and yields content, enabling consistent
    styling and behavior for secondary link buttons across the app.
2025-12-21 Replace `{ inject as service }` with `{ service }`
    [course-idea-card.gts, submit-course-idea-card.gts, vote-button.gts]
2025-12-21 Include `.gts` and other combined js-template files in `.prettierrc.js`
    [course-idea-card.gts, submit-course-idea-card.gts, unvote-button.gts, vote-button.gts]
2025-12-28 feat(progress-donut): add customizable color prop for donut
    Add an optional color argument to ProgressDonut component to allow
    selection among blue, teal, and gray color themes. Replace hardcoded
    color classes with computed properties that apply proper stroke
    classes based on the selected color.
    This change enhances the component's flexibility and supports theming
    without modifying markup or styles externally. The default color
    remains teal to preserve existing appearance.
2025-12-28 feat(progress-bar): show check icon for completed progress
    Replace progress donut with a teal check-circle icon when all stages
    are completed in track, course, and usage progress bars. This improves
    visual clarity by distinctly marking completion, and simplifies styles
    by applying consistent teal text color throughout.
2025-12-28 fix(progress-bar): increase course progress text size
    Increase the font size of the course progress text from xs to sm
    to improve readability and enhance the UI consistency on the
    track page course card.
2025-12-28 refactor(loading-skeleton): simplify component and update usage
    Remove width argument and related style logic from LoadingSkeleton to
    simplify the component. Replace width prop with utility CSS classes
    for sizing and styling in skeleton-row template.
    Update all LoadingSkeleton instances to use consistent TailwindCSS
    classes for width, height, and border radius, improving maintainability
    and flexibility across different loading placeholders. Adjust colors
    and dimensions for better visual consistency in light and dark modes.
2025-12-28 style: update dark mode border colors for better contrast
    Change dark mode border colors from gray-700 to white with 5% opacity
    to improve visual contrast and consistency across components in the
    track header and primer concept group section. This enhances readability
    and aligns with the updated design guidelines.
2025-12-28 fix(leaderboard): improve surrounding entries visibility logic
    Update shouldShowSurroundingEntries to check for overlap with top
    entries instead of user-in-top condition. Add surroundingEntriesOverlapsTopEntries
    getter to determine if any surrounding entries appear in top entries.
    Filter banned entries in sortedTopEntries to exclude them from display.
    These changes ensure the leaderboard accurately displays surrounding
    entries without duplication or overlap with top entries.
2025-12-28 feat(leaderboard): refactor entry sections and improve sorting
    Introduce separate getters for first and second leaderboard sections to
    handle overlapping entries and filtering banned users more clearly.
    Update template to render from these new computed properties, ensuring
    accurate ranking and display logic. This refactor improves maintainability
    and correctness of the leaderboard entries display.
2025-12-28 refactor(leaderboard): unify entries caching and rendering logic
    Refactor LeaderboardEntriesCache to provide unified entry lists with ranks
    and encapsulate sorting and filtering logic. Update template and component to
    consume the new structured entriesCache API, replacing multiple separate entry
    props with a single source of truth. This improves code clarity, maintainability,
    and ensures consistent handling of loading state and banned entries.
2025-12-28 refactor(leaderboard): rename and restructure internal properties
    Rename private tracked properties with a leading underscore to clearly
    distinguish internal state. Simplify declarations by removing unnecessary
    modifiers and initialize isLoaded in the constructor. Refactor getters
    to use updated property names and improve readability by consolidating
    sorting and filtering logic. Update async task method call to use new
    naming convention. These changes improve code clarity and maintainability
    without altering external behavior.
2025-12-28 refactor(utils): simplify and clarify leaderboard entry sorting
    Rename the getter to _sortedEntriesForFirstSection and inline the logic
    to filter out banned entries and sort by score. This removes unnecessary
    intermediate steps, improving code readability and maintainability.
2025-12-28 refactor(modifiers): replace model-did-update with generic on-action-cable-message
    Remove the model-did-update modifier which was limited to models and
    tied to specific channels. Introduce a new on-action-cable-message
    modifier that accepts any ActionCable channel and arguments, enabling
    more flexible and reusable subscriptions.
    Update course-admin tester version template to use the new modifier
    with explicit channel name and args, simplifying the event handling
    logic and improving maintainability.
    This change standardizes ActionCable subscription handling and reduces
    code duplication by creating a generic solution.
2025-12-28 fix(modifier): add cleanup call before subscribing to channel
    Add a call to cleanup() before creating a new Action Cable subscription
    to ensure any previous subscriptions are properly removed. This avoids
    potential memory leaks and duplicate callbacks when subscribing to the
    same channel multiple times.
2025-12-28 feat(modifier): add conditional filtering to on-visibility-change
    Enhance the on-visibility-change modifier to accept an optional
    "if" named argument that filters callback invocation based on tab
    visibility state. The callback now triggers only when the document
    visibility matches the specified condition ("visible" or "hidden").
    This prevents unnecessary callback calls and allows more precise
    control over visibility-based behavior in components.
2025-12-28 feat(on-visibility-change): add conditional filtering by visibility state
    Allow the on-visibility-change modifier to accept an optional
    `if` named argument to filter callback invocation by visibility state.
    The callback is invoked only when the document visibility matches the
    specified condition ('visible' or 'hidden'). This enhances flexibility
    by letting users respond to specific visibility changes instead of all.
2025-12-28 test: remove redundant poller test and improve extension tests
    Remove the legacy repository-poller-test that redundantly checked poller
    instances during stage navigation.
    Refactor extensions acceptance tests to use a FakeActionCableConsumer
    instead of forcing pollers to poll. This simulates real-time updates
    via WebSocket events more accurately, improving test reliability and
    rendering synchronization.
    Add a helper finishRender to better wait for UI updates after fake
    ActionCable events. These changes make the extension tests more robust
    and closer to real app behavior.
2025-12-28 fix(modifiers): correct action cable event handlers
    Swap onData and onConnect callbacks in the Action Cable subscription
    to ensure the correct events trigger the callback and log messages.
    This fixes misleading logs and aligns the event handling with the
    expected lifecycle of the subscription.
2025-12-28 test: register FakeActionCableConsumer in course start test
    Replace real Action Cable consumer with a fake implementation in the
    'can start course with workflow tutorial' test to improve test isolation
    and prevent external connections during acceptance testing.
    Cleanup imports in various tests by removing unused 'settled' and
    'animationsSettled' imports for better code clarity and consistency.
2025-12-28 test: update acceptance tests to reflect new API request flows
    Modify API request expectations in acceptance tests for course and
    catalog pages to replace polling endpoints with fetch/update calls
    after subscription events. This change aligns test mocks with the
    updated client behavior, ensuring accurate simulation of API usage
    and improving test reliability.
2025-12-28 test: improve verifyApiRequests to check new requests only
    Update verifyApiRequests to track the last checked request index and
    only verify new API requests since the last check. This prevents
    re-verification of previously checked requests and ensures incremental
    validation during tests. This change improves efficiency and accuracy
    when verifying server requests over multiple test stages.
2025-12-28 test: integrate FakeActionCableConsumer in acceptance tests
    Replace manual poller triggers with fake Action Cable events in
    course-page acceptance tests to better simulate real-time updates.
    Change sendData in FakeActionCableConsumer to accept object data and
    send JSON strings to match the expected format.
    Register FakeActionCableConsumer as the service in tests to enable
    dispatching channel update events, improving test realism and coverage.
2025-12-28 test(acceptance): enhance API request verifications in start course test
    Refactor start-course-test to more accurately verify the sequence of API
    requests at each navigation step: visiting the catalog, opening the course
    overview, starting the course, and selecting a language. Add checks for
    additional repository polling and leaderboard refreshes after subscription
    events to ensure the app triggers expected calls. These changes improve test
    coverage and reliability by validating detailed backend interactions throughout
    the course start flow.
2025-12-29 feat(leaderboard): enhance leaderboard data handling and UI
    Refactor leaderboard fetching and sorting logic to use the new
    'leaderboard-entry' model filtered by leaderboard ID and banned status.
    Update language query to include leaderboard relations for consistent data.
    Revamp leaderboard component template to display entries with ranks,
    support multiple sections, and improve empty state messaging from
    "no recent activity" to "no one has completed any stages yet" for clarity.
2025-12-29 test: simplify API request verification in acceptance tests
    Remove explicit API request sequence assertions in try-other-language-test to
    reduce test fragility and maintenance overhead. Adjust the order of API
    endpoints in switch-repository-test to improve consistency. These changes
    focus on making tests more resilient and easier to update without relying
    on a fixed sequence of API calls.
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2025-12-29 refactor(leaderboard): replace entry component with row component
    Remove TrackLeaderboardEntry model, utility, and component to simplify
    leaderboard rendering. Introduce TrackLeaderboard::Row component that
    renders user avatar, username, rank, and score within a LinkTo element.
    Add highlighting for the current user based on authentication service.
    This change improves performance and code maintainability by relying
    on plain arguments and removing unnecessary model abstractions.
2025-12-29 Add utility to create track leaderboard entries and update test assertion message.
2025-12-29 fix: adjust sticky top offset in right sidebar component
    Increase the sticky top offset from 14 to 16 to improve layout
    spacing and prevent overlap with other fixed elements when the
    sidebar is expanded or collapsed. This ensures better visual
    alignment and user experience.
    feat(course-page): extract right sidebar to reusable component
    Move the leaderboard sidebar and its controls into a new
    CoursePage::RightSidebar component. This consolidates markup
    and logic, improving maintainability and reducing duplication
    in the course template. The sidebar toggles expansion state
    and conditionally shows a private leaderboard feature
    suggestion based on the current user's permissions.
2025-12-29 refactor(language-leaderboard): move user rank loading to cache service
    Replace direct store usage for user rank calculation with a cached
    leaderboardEntriesCacheRegistry service to centralize leaderboard data
    management and improve data reuse.
    Update component to trigger rank refresh on construction and use a new
    refreshRankTask to load data via the cache. Adjust template to show a
    loading state based on task status rather than null checks.
    Add userRankCalculation getter to leaderboard-entries-cache utility for
    easier access to rank data.
    concurrent(course-stage-completion): run refresh operations in parallel
    Change repository refresh and user sync calls to run concurrently using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
2025-12-29 feat(course-overview): support checking course start with language
    Update start-course-button to check if the current user has started
    a course using a specified language. Return false if there is no
    current user. This enables conditional UI behavior based on language
    context when determining course progress.
2025-12-29 test: remove obsolete feature flag setup in acceptance test
    Remove the update of the currentUser feature flag for leaderboard visibility,
    as the leaderboard feature is no longer behind a feature flag. This cleans up
    the test setup and simplifies test conditions.
2025-12-29 feat(track-leaderboard): add leaderboard feature to course page
    Add a feature flag to conditionally show the track leaderboard on the
    course page for test users and staff. Update the template to include a
    test selector for the leaderboard title, and implement a page object
    model for interacting with the leaderboard in tests. Integrate the new
    page object into the course page test setup to enable testing of the
    leaderboard component.
    This change enables controlled rollout and testing of the track
    leaderboard feature.
2025-12-29 feat: update leaderboard logic on course stage completion
    Refactor variable naming for clarity in course leaderboard entry.
    Enhance afterCreate hook to also create or update language leaderboard
    entries, incrementing user score per language. Change POST handler to
    use server.create() instead of schema.create() ensuring afterCreate
    hooks are triggered. These improvements maintain consistent leaderboard
    state across course and language levels after a stage completion.
2025-12-29 feat(course-page): add track leaderboard support and user lang preference
    Add track property to the right sidebar to enable track-based leaderboard
    display alongside repositories. Implement logic to select language for the
    leaderboard using active repository language, then track slug, then user
    preferred languages, and fall back to course languages if none match.
    This allows personalized leaderboard views and prepares for enabling track
    leaderboard feature flags with improved language resolution.
    Add acceptance test to verify leaderboard progress and interactions tied to
    track leaderboard feature.
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2025-12-30 feat(course-overview): prioritize current language in language list
    Replace direct usage of betaOrLiveLanguages with an orderedSupportedLanguages
    computed property that sorts languages to show the current language first,
    followed by others in alphabetical order. Also switch from using img tags for
    language logos to a LanguageLogo component with consistent styling. These
    changes improve user experience by highlighting the active language and
    standardize language logo rendering.
2025-12-30 style(join-track): adjust sidebar spacing and layout
    Update the sticky sidebar container to use top-6 and increase left margin
    to ml-6 for better alignment and spacing on large screens. Remove the
    left margin from the AcceptReferralContainer component to reduce unnecessary
    horizontal padding. Also, eliminate horizontal margins around the testimonials
    wrapper to unify the layout and prevent extra space on the sides.
    These changes improve visual consistency and alignment of sidebar elements
    within the join track page for a cleaner user interface.
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2025-12-31 fix(styles): add dark mode hover color to track card title
    Ensure the track card title changes color on hover in dark mode
    when navigating to another page by adding 'dark:group-hover:text-teal-500'.
    This improves visual feedback consistency across light and dark themes.
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2025-12-31 Fix: Do not show stage incomplete modal if tests passed
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2026-01-01 Refactor: Switch from npm to Bun for dependency management
    This commit replaces npm with Bun across the project. This includes updating scripts, workflows, and documentation to use Bun commands and its lockfile. This change aims to improve performance and streamline the development workflow.
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2026-01-01 test: fix missing await in track-viewed-page-events test
    Add await before waitUntil to ensure asynchronous operation
    completes correctly in track-viewed-page-events-test.js. This
    change prevents potential test flakiness by properly waiting for
    the expected number of viewed page events.
2026-01-01 feat(track-leaderboard): improve leaderboard CTA with course stage and repo
    Update TrackLeaderboard and related components to pass current course
    stage and repository context to computeLeaderboardCTA. This replaces the
    previous approach of passing nextStagesInContext, simplifying context
    management and improving accuracy of the leaderboard call-to-action
    logic. Remove unused nextStagesInContext computation and ensure the CTA
    reflects the current step and repository state on course pages.
2026-01-01 fix(course-page): remove redundant step validation in sidebar
    Remove the check that compares currentStep and activeStep in the
    right-sidebar component. This validation is unnecessary as it causes
    the function to return undefined incorrectly, blocking the course
    stage retrieval. The change simplifies the logic and ensures the
    correct course stage is returned consistently.
2026-01-01 style(components): scope leaderboard link hover styles
    Update the leaderboard link in track-leaderboard component to use
    a more specific CSS group class for the hover state. Replace the
    generic "group" class with "group/leaderboard-title" to prevent
    style conflicts and ensure hover effects only apply within the
    leaderboard title context. Adjust the related SVG rotation classes
    to use the new scoped group selector for consistent transitions.
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2026-01-05 fix(support-section): correct button position in support text
    Update the support section text to refer to the button below
    instead of above, improving accuracy and clarity for users seeking
    billing help.
2026-01-05 refactor(tests): modularize pay-page test page object
    Extract chooseMembershipPlanModal into its own component to improve
    test code organization and reuse. Replace the inline modal definition
    in pay-page.js with an imported choose-membership-plan-modal component
    and switch to using createPage helper for consistency and clarity.
2026-01-05 feat(pay-page): add customizable close modal CTA to plan modal
    Replace back-to-pricing-page link with a configurable close modal
    call-to-action button in the membership plan selection step. Update
    checkout session URLs to use dynamic success and cancel paths. Improve
    test coverage to reflect these UI changes.
    These updates enhance flexibility for modal actions and support
    dynamic navigation flows after checkout.
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2026-01-06 feat(course-setup): add CLI ping step controlled by feature flag
    Introduce a new "Test CLI connection" setup step that replaces the
    previous "Push empty commit" step when the `canViewCLIPingFlow`
    feature flag is enabled. Update related UI text and instructions to
    reflect this new flow, including the addition of a reusable command
    component for running CLI connection tests.
    This change enables a smoother onboarding experience for users with
    access to experimental CLI ping functionality, controlled via a
    feature flag to allow gradual rollout without impacting existing users.
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2026-01-10 Fix: Reset membership plan modal state on insert
2026-01-10 fix(alert): adjust dismiss button styles for better consistency
    Reduce dismiss button padding and icon size for improved visual balance.
    Modify dark mode border opacity to 50% for all colors to enhance
    contrast and consistency across themes.
2026-01-11 Fix: Import community-course-stage-solution model
2026-01-17 fix(course-idea-card): fix tooltip transparency issue in released course idea cards Render the tooltip in `#application-container` instead of in-element
    [course-idea-card.gts]
2026-01-17 feat(vote-button): add isDisabled argument to vote-button component
    - Add optional isDisabled boolean argument to Args interface
    - Apply cursor-default styling when disabled, cursor-pointer when enabled
    - Disable button element when isDisabled is true
    - Remove hover effects when disabled by conditionally applying group-hover classes
    [vote-button.gts]
2026-01-17 feat(course-idea-card): prevent voting on released course ideas
    - Add check to handleVoteButtonClick to prevent voting if developmentStatusIsReleased is true.
    - Update VoteButton to use isDisabled argument for consistent button behavior when course idea is released.
    [course-idea-card.gts]
2026-01-17 fix(track-page): open concept links in a new tab instead of redirecting
2026-01-20 Refactor border classes in course extension and idea card components.
    [course-idea-card.gts]
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2026-01-23 feat(routes): refactor course stage concepts and update routing
    Add a new TypeScript route for course stage concepts to improve type
    safety and data loading. Replace the deprecated login and course stage
    routes with streamlined logic focused on correct data fetching and
    redirection. Change index and tracks routes to correctly declare the
    router service with types. Update roadmap course extension ideas route
    to properly handle controller setup with transition parameter. These
    changes improve maintainability, typing, and app navigation consistency.
2026-01-23 Fix unsafe optional chaining and constructor signature issues
    - logged-in.ts: Add null check before using redirectUri and sessionToken
    values from transition.to?.queryParams to prevent passing undefined
    to setToken() and window.location.href
    - course/stage.ts: Fix constructor signature to use spread pattern
    (...args: object[]) matching the established Ember pattern used in
    other routes like concept.ts
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2026-01-30 Fix duplicate evaluator creation on rapid clicks
    - Change task modifier from 'keepLatest' to 'drop' to prevent duplicate
    task execution when user clicks rapidly
    - Add @isDisabled binding to prevent button interaction while task is running
    - Follows existing codebase pattern (e.g., createAutofixRequestTask)
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2026-01-30 feat(editable-text-field): add inline editing component with validation
    Introduce EditableTextField component to support inline text editing with
    cancel and confirm actions. Display an input field with action buttons when
    editing or when error messages are present. This improves UX by enabling
    quick, contextual edits without navigating away.
    style(theme): apply dark mode styles across components
    Update color classes and text colors in multiple components to support dark
    mode. Ensure consistent theming, including text, borders, icons, and backgrounds,
    to improve accessibility and visual coherence in dark mode.
    refactor(course-admin/code-example-evaluator): enable slug editing inline
    Repla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
2026-01-30 feat(course-admin): add more dropdown to evaluate more solutions
    Replace the standalone "Evaluate solutions" button with a new MoreDropdown
    component that houses the "Evaluate more solutions" action. This change improves
    the UI by grouping related actions in a dropdown, enhancing user experience and
    allowing for future extensibility. The dropdown toggles its icon color based on
    open state, and closes automatically after triggering the evaluation task.
2026-01-31 feat: track source URLs for fetched file contents
    Add tracked properties to store the URLs used to fetch logs and prompt
    file contents in community solution and submission evaluations. Update
    fetchFileContentsIfNeeded to accept and check these source URLs, avoiding
    unnecessary refetching when the URL hasn't changed.
    Also, rename context toggling in code-example-evaluator-page from
    'changed_files' to 'highlighted_lines' to better reflect intended usage
    and update related UI bindings accordingly.
2026-01-31 refactor: improve filters and enhance insights metadata display
    Remove the course_id filter from buildContextFilters to allow for
    more flexible evaluator filtering; add a TODO to revisit this for
    course-specific evaluators. Update metadata-container to correctly
    display evaluation results without misleading suffixes and append
    "(draft)" to indicate draft evaluators clearly. Add consistent route
    color scheme metadata in the code-example-insights-index route for
    better UI theming and user experience.
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2026-02-04 Remove 5 glint-nocheck comments and convert JS components to TypeScript
    - discuss-on-hn-button: Converted JS to TS with Signature (link arg)
    - external-contributor-card: Converted JS to TS with Signature (contributorDetails arg)
    - feedback-button/sentiment-option: Converted JS to TS with Signature (isSelected, emoji args)
    - course-page/collapse-sidebar-button: Fixed Element type to HTMLButtonElement, removed nocheck
    - create-team-page/features-list-item: Removed nocheck (already had proper TS types)
2026-02-04 Remove unused @glint-expect-error directive in feedback-button/index.hbs
    Now that SentimentOption is properly typed, the expect-error directive is no longer needed.
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2026-02-05 fix: update test to expect CLI by default for stage 2
    Since we removed the CLI ping flow feature flag, CLI is now always
    recommended by default for all stages, including stage 2. Updated
    the test name and assertions to reflect this new behavior.
2026-02-05 Fix inconsistent messaging between setup and first stage steps
    Update first stage progress indicator to show 'Listening for ping...' instead of
    'Listening for a git push...' to be consistent with the setup step messaging.
2026-02-05 refactor: optimize evaluation rate calculations and add live updates
    Replace allEvaluations filtering with precomputed counts in the
    accuracy-section component for fail and pass rate calculations to
    improve performance and accuracy. Add failedEvaluationsCount,
    passedEvaluationsCount, and unsureEvaluationsCount attributes to the
    CommunitySolutionEvaluator model along with a computed
    totalEvaluationsCount getter.
    Enhance the template to listen to ActionCable messages on the
    CommunitySolutionEvaluatorChannel, enabling real-time updates by
    reloading evaluator data on incoming messages. Add handleActionCableMessage
    action to the controller for this purpose. This change ensures the
    accuracy stati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
2026-02-05 Fix DangerButton size mismatch by using BaseButton
    The DangerButton had hardcoded padding (px-3 py-2) regardless of size,
    while PrimaryButton uses BaseButton which has size-specific padding:
    - extra-small: px-1.5 py-1
    - small: px-2 py-1.5
    - regular: px-3 py-2
    - large: px-4 py-3
    Refactored DangerButton to use BaseButton like PrimaryButton does,
    ensuring consistent sizing between the two button types.
    Also updated the size type in both DangerButton and
    DangerButtonWithTimedConfirmation to use BaseButtonSignature's type
    for better type safety.
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2026-02-16 Add custom status messages for system-initiated test runs
    When the previous test run was initiated by 'system':
    - In progress: 'Checking next stage…' (yellow, blinking)
    - Failed: 'Ready to run tests' (gray, no blinking)
    - Passed: 'Next stage already implemented!' (green, no blinking)
    This improves the UX by not showing confusing 'Tests failed' messages
    when the system auto-runs tests for the next stage after completing one.
2026-02-16 Simplify system-initiated status messages with inline ternaries
    - Use ... (triple dots) instead of unicode ellipsis
    - Use inline ternary for evaluating case (only message differs)
    - Use inline ternary for passed case (only message differs)
    - Keep failed case as separate block (entirely different styling)
2026-02-16 fix(modal-body): make allowManualClose prop required
    Change allowManualClose from optional to required in the modal-body
    component. This ensures explicit control over the manual close behavior
    and prevents potential undefined states when closing the modal.
2026-02-17 refactor(modals): enable close buttons and outside click to close
    Update modals in course page and tests passed to allow closing by clicking
    outside or via a close button for improved usability. Reduce modal max-width
    to max-w-2xs for better responsiveness. Remove redundant "Show instructions again"
    buttons across multiple modals to simplify UI and avoid clutter. Adjust close
    button positioning for better alignment across screen sizes.
2026-02-17 refactor: remove dead onViewInstructions props from modal components
    Remove onViewInstructionsButtonClick from StartWorkflowTutorialScreen and
    StepPreviouslyCompletedScreen, and onViewInstructionsLinkClick from
    ChooseActionStep, SubmitCodeStep, and RefactorCodeStep.
    These props were still being passed and declared in TypeScript signatures
    but were no longer consumed in the templates after the 'Show instructions
    again' buttons were removed.
2026-02-17 fix: add missing max-width constraint to setup step complete modal
    The ModalBody in setup-step-complete-modal.hbs lost its class attribute
    entirely when the old 'px-0! py-0! max-w-xl' was removed. The px-0!/py-0!
    removal was intentional, but the width constraint was also accidentally
    dropped. Add 'w-full max-w-sm' to match the pattern used by
    current-step-complete-modal and properly constrain the modal width.
2026-02-17 fix(ui): simplify leaderboard rank text in language section
    Remove redundant language name from the leaderboard rank text to
    make the message clearer and more concise for users in the
    current-step-complete modal. This improves readability and UI
    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
2026-02-17 fix(tests-passed-modal): update action button title text
    Simplify the action button title from "Marking stage as complete..." to
    "Marking stage complete..." for clearer and more concise UI feedback.
2026-02-17 Fix processing label text for stage completion button
2026-02-17 feat(course-stage-step): add SolutionWithHints component with hint cards
    Introduce a new SolutionWithHints component to display hints with expand/collapse
    behavior and a blurred solution overlay that can be revealed. This includes tracking
    analytics events for hint interaction and solution reveals.
    Integrate the SolutionWithHints component into the YourTaskCard when a relevant
    solution exists for the current repository language.
    Fix component registry type to correctly reference SolutionWithHints instead of the
    previous incorrect component.
2026-02-17 refactor(course-stage-step): replace ImplementSolutionStep with HowToPassStepList
    Remove the ImplementSolutionStep component and template in favor of a new,
    more comprehensive HowToPassStepList component that lists steps to complete the
    stage. This change improves clarity by explicitly showing the "implement solution"
    and "run tests" steps along with their completion status.
    The new component consolidates step logic, handles completion detection for each
    step, and includes an action to expand test logs, enhancing the user experience
    and maintainability.
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2026-02-21 feat(course-page): replace previous steps notice with pill and improve animation
    Remove the PreviousStepsIncompleteNotice component and replace it with a more
    compact PreviousStepsIncompletePill displayed inside a sticky container. This
    change declutters the UI by showing a less intrusive indicator when previous
    steps are incomplete.
    Enhance the modal dismissal animation using ember-animated with a custom
    transition that applies fade and move effects for inserted, kept, and removed
    sprites, improving the overall user experience and visual polish.
    Adjust transition duration from 150ms to 200ms for smoother appearance timing.
2026-02-21 feat(course-page): make previous steps pill a link to active step
    Change the PreviousStepsIncompletePill component to render as a link
    (<LinkTo>) instead of a div. This enables users to navigate directly
    to the active incomplete step by clicking the pill, improving
    usability and navigation flow. Update the component's root element
    type accordingly and streamline the inner "Back" button to a styled
    span, avoiding nested links. Add hover styles for better visual
    feedback on interaction.
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2026-02-22 feat(course-stage-step): add animated TestsPassedPill with custom transition
    Replace TestsPassedNotice modal with a new TestsPassedPill button that is
    sticky and less intrusive. Implement a custom animated transition using
    ember-animated, applying fade and move motions with easing for inserting,
    keeping, and removing sprites. This improves the user experience by
    providing a smoother, visually appealing feedback when tests pass and the
    overlay is shown or hidden.
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2026-02-22 feat(current-step): add animated pill for step completion
    Replace the modal overlay with a new animated CurrentStepCompletePill
    component that links to the next step or relevant completion step.
    Implement custom enter/leave transitions for the current-step completion
    overlay using ember-animated motions for fade and move with easing.
    This improves user experience by providing a less intrusive,
    persistent confirmation of step completion and a clear call to action
    to proceed, with smooth animations enhancing visual feedback.
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2026-02-26 fix(billing): dynamically display discount percentage in badge tooltip
    Update discount-timer-badge to show the actual discount percentage
    from args instead of a hardcoded value. This makes the tooltip text
    accurate and adaptable to different discount values.
2026-02-26 test: remove feature flag fetch and user updates for CLI ping flow
    Remove pre-caching of deprecated workflow animation GIF tied to the
    can-view-cli-ping-flow feature flag in the setup-step-complete-modal
    component to simplify asset loading.
    Eliminate user feature flag updates in acceptance tests since the flag
    is no longer required, cleaning up test setup and improving clarity.
2026-02-26 Reorder tests-passed modal options and add (optional) to refactor code
    - Move 'Refactor code' option above 'Mark stage as complete' so the
    final action is clearly completing the stage
    - Rename to 'Refactor code (optional)' so users know they can skip it
2026-03-02 Fix double advance on unfocused Enter in concept flow
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2026-03-12 Update header logo and favicon to match landing site
    - Replace old logomark with new logo icon, with dark/light variants
    that swap based on color scheme (dark logo for light mode, light
    logo for dark mode)
    - Update favicon to SVG with light/dark mode support
    - Add Source Serif 4 font for serif logo text styling
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2026-03-31 Refactor multi-section card and tertiary button components
    - Updated the `multi-section-card` to include an optional `expandedTitle` for sections, enhancing the display logic.
    - Improved the layout by adding a section index indicator and adjusting flex properties for better alignment.
    - Modified the `tertiary-button` styles to ensure consistent border colors in dark mode.
    - Removed redundant text from the `select-language-section` for a cleaner presentation.
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2026-04-03 fix: use focus-on-insert modifier instead of fragile next() for question card focus
    The previous approach scheduled focus via next() in a did-insert callback,
    which created a race condition on slow CI runners. Replace with the
    focus-on-insert modifier (already used by the Continue button) which
    fires synchronously during the Glimmer rendering lifecycle.
2026-04-03 fix: add animationsSettled() to start-course workflow tutorial test
    MultiSectionCard uses animated-if transitions between sections. During
    the transition, the expandedSection yield block exists in both the
    outgoing and incoming containers simultaneously, which can duplicate
    elements like data-test-continue-button. Wait for animations to settle
    between section-triggering interactions.
2026-04-03 fix: call focus() directly instead of deferring with next(), fix lint errors
    Replace the focus-on-insert modifier approach (which had Glint typing
    issues) with direct focus() in the did-insert handler — removing the
    next() deferral that caused race conditions on slow CI runners.
    Also fix member-ordering lint error in live-call-widget-admin.
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2026-04-05 fix: team v2 - icon remove button, reorder columns, short date format
    - Replace remove/leave text with X icon + tooltip
    - Rename 'Last Active' to 'Last Seen', move to first data column
    - Rename 'Stage Attempts' to 'Stages'
    - Add short-relative-time helper (1d ago, 3mo ago, 2y ago)
2026-04-05 fix: team v2 - truncated names, scrollable courses, improved sort
    - Truncate member names at ~13 chars with CSS truncation and external link icon
    - Courses column: max 4 icons wide, horizontally scrollable with fade
    - Sort: stages desc > last seen desc > joined desc
    - Tighter column spacing
2026-04-05 feat: promote team v2 to main team page, fix tooltip alignment
    - Replace old team page with the new table-based layout
    - Remove v2 route, controller, and template
    - Fix tooltip alignment on remove button (side=left)
    - Add data-test attributes for existing test compatibility
    All 9 team-page tests pass.
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2026-04-09 fix: remove stages column, use proven numberOfStageAttempts for all-time default
2026-04-09 fix: gate period filter behind q=v2 query param, limit sorting to Last Seen only
    - Duration dropdown only renders when ?q=v2 is in the URL
    - Removed sorting from all columns except Last Seen
    - Default sort restored to original: attempts desc, last seen desc, joined desc
    - Last Seen sort toggles: desc -> asc -> default
2026-04-09 revert: remove duration filter, extra columns, and most sorting; keep Last Seen sort
    Reverts all team members table changes except:
    - Last Seen column is now sortable (click to toggle desc/asc/default)
    - Column still labeled "Stages" using the original numberOfStageAttempts attribute
    Removed:
    - Duration toggle and q=v2 query param gating
    - enablePeriodFilter arg and all period-related code
    - 8 unused model attributes (numberOfAttempts, numberOfAttempts3m, etc.)
    - Attempts column rename (back to Stages)
    - headerRight named block on Section component
    - Extra test attributes in auth helpers and acceptance tests
2026-04-09 fix: add role=button to sortable th for lint compliance
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2026-04-24 refactor: enhance visitor data synchronization in Lobbyside widget
    Updated the Lobbyside widget to track individual visitor fields (`userPrimaryEmail`, `userName`, `userGithub`) in the `did-update` lifecycle hook. This change ensures that the visitor data is re-synced whenever any of these fields change, addressing issues with Ember Data's two-pass hydration that could leave the email field empty. Added comments for clarity on the importance of these changes.
2026-04-24 refactor: improve visitor data synchronization in Lobbyside widget
    Enhanced the `did-update` lifecycle hook to track both `currentUserId` and individual visitor fields (`userPrimaryEmail`, `userName`, `userGithub`). This change ensures accurate re-synchronization of visitor data during identity transitions and in-place mutations, addressing potential stale data issues caused by Ember Data's two-pass hydration. Updated comments for clarity on the rationale behind these modifications.
2026-04-27 fix: reset staff acknowledgment status on feedback submission close
    Updated the feedback submission handling to set `isAcknowledgedByStaff` to false when the submit button is clicked, ensuring proper state management for feedback submissions.
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2026-05-23 fix pricing FAQ challenge count
    Bumps challenge count from 10 to 11 and adds "Build Your Own Claude
    Code" to the list. The Claude Code beta course is publicly visible on
    the catalog, so it should be counted alongside the 10 live courses.
    Stage and language counts remain accurate.
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2026-05-23 Fix track page card count expectation
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2026-06-22 Push non-primary emails to Lobbyside via dedicated endpoint
    Re-introduces the other_emails custom field (reverted in #3870) without
    the fatal change: instead of adding email-addresses to the /users/current
    include (which that endpoint rejects, breaking the auth bootstrap), load
    them via the dedicated GET /email-addresses endpoint the institution flow
    already uses. The load is fire-and-forget + caught in syncCurrentUser so a
    failure can never reject the current-user bootstrap again.
    Adds a regression test asserting auth still completes when /email-addresses
    500s, plus a test that currentUser.emailAddresses populates for the widget.
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2026-10-18 Align app footer with marketing website (#3879)
    * Align app footer with marketing website
    * Correct LinkedIn footer destination
    * chore(lint): auto-fix lint offenses
    * Refine footer links and add background mark
    * Tighten mobile footer labels and columns
    * Tighten mobile footer group spacing
    *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
